DaveGuenther/Guenther-Chiptune/Guenther Chiptune Schematic.pdf

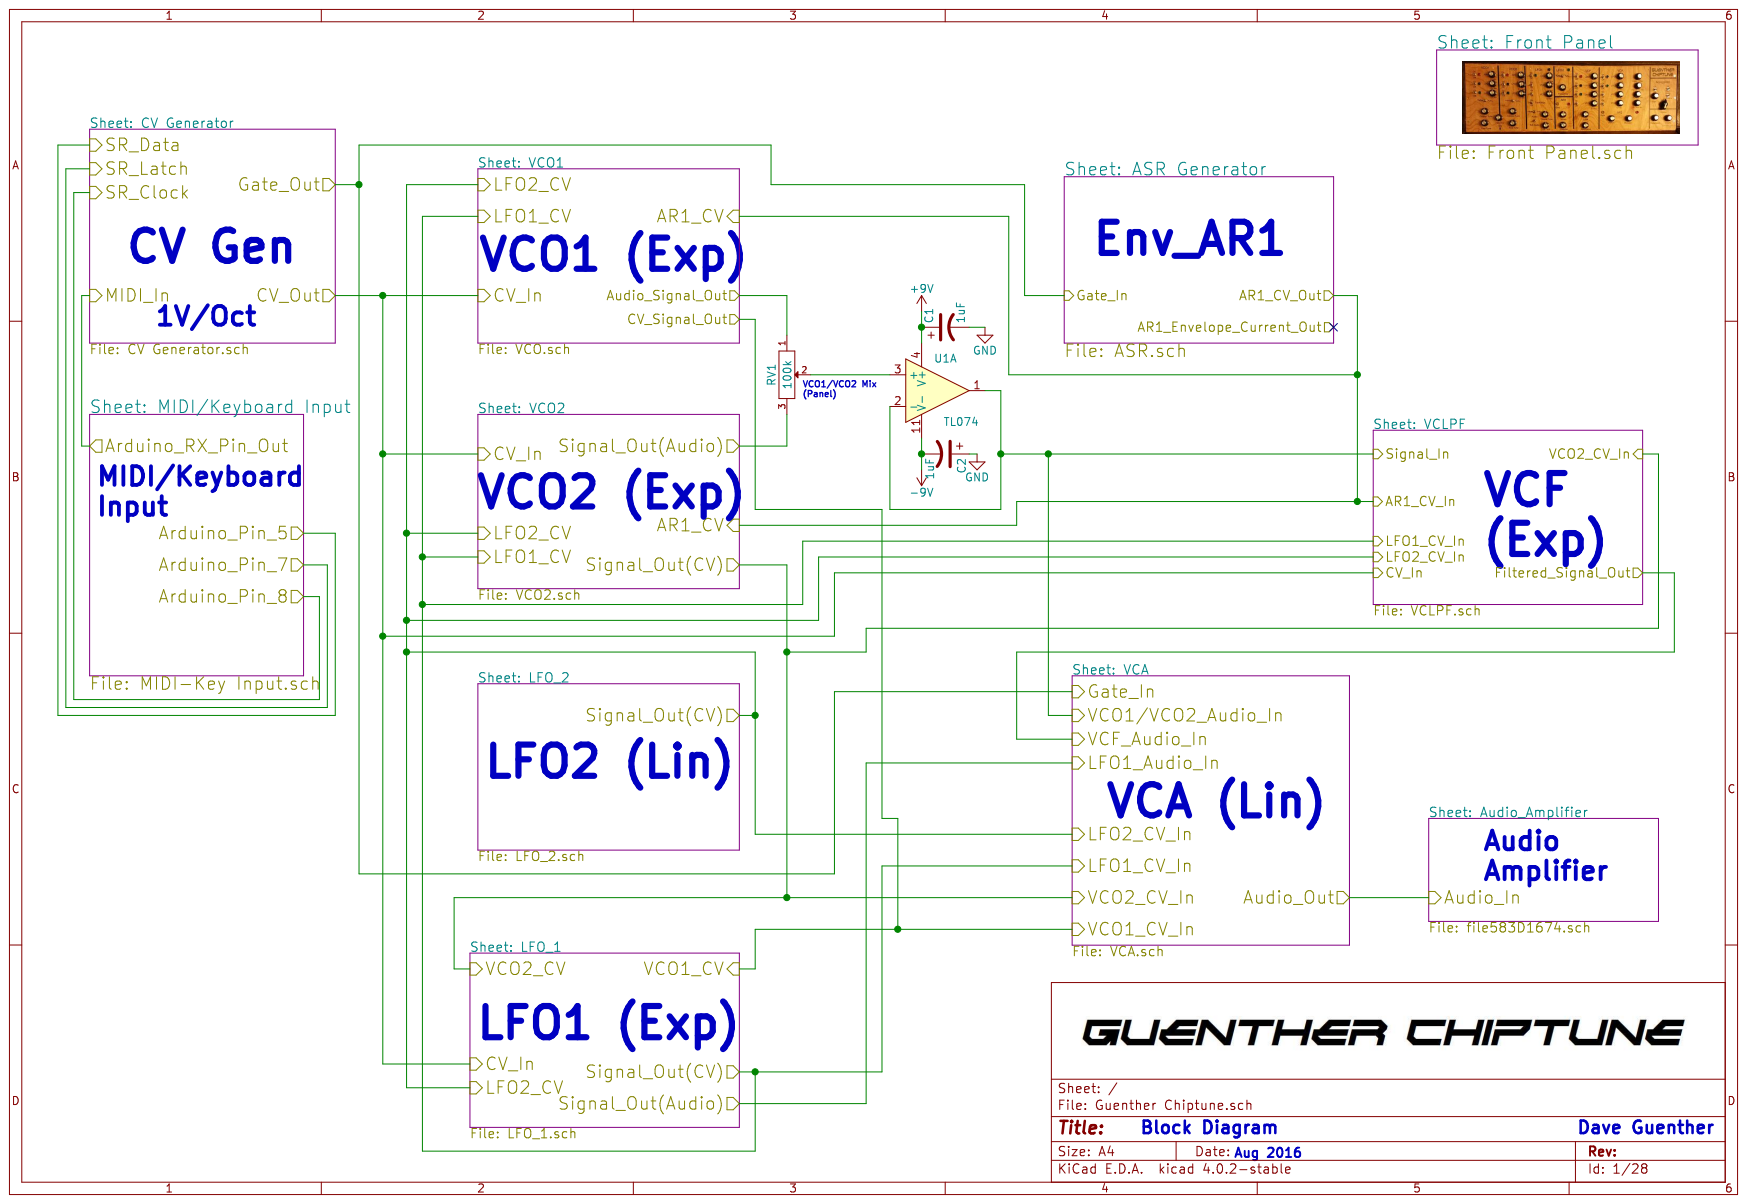
[picture p1: page 1]

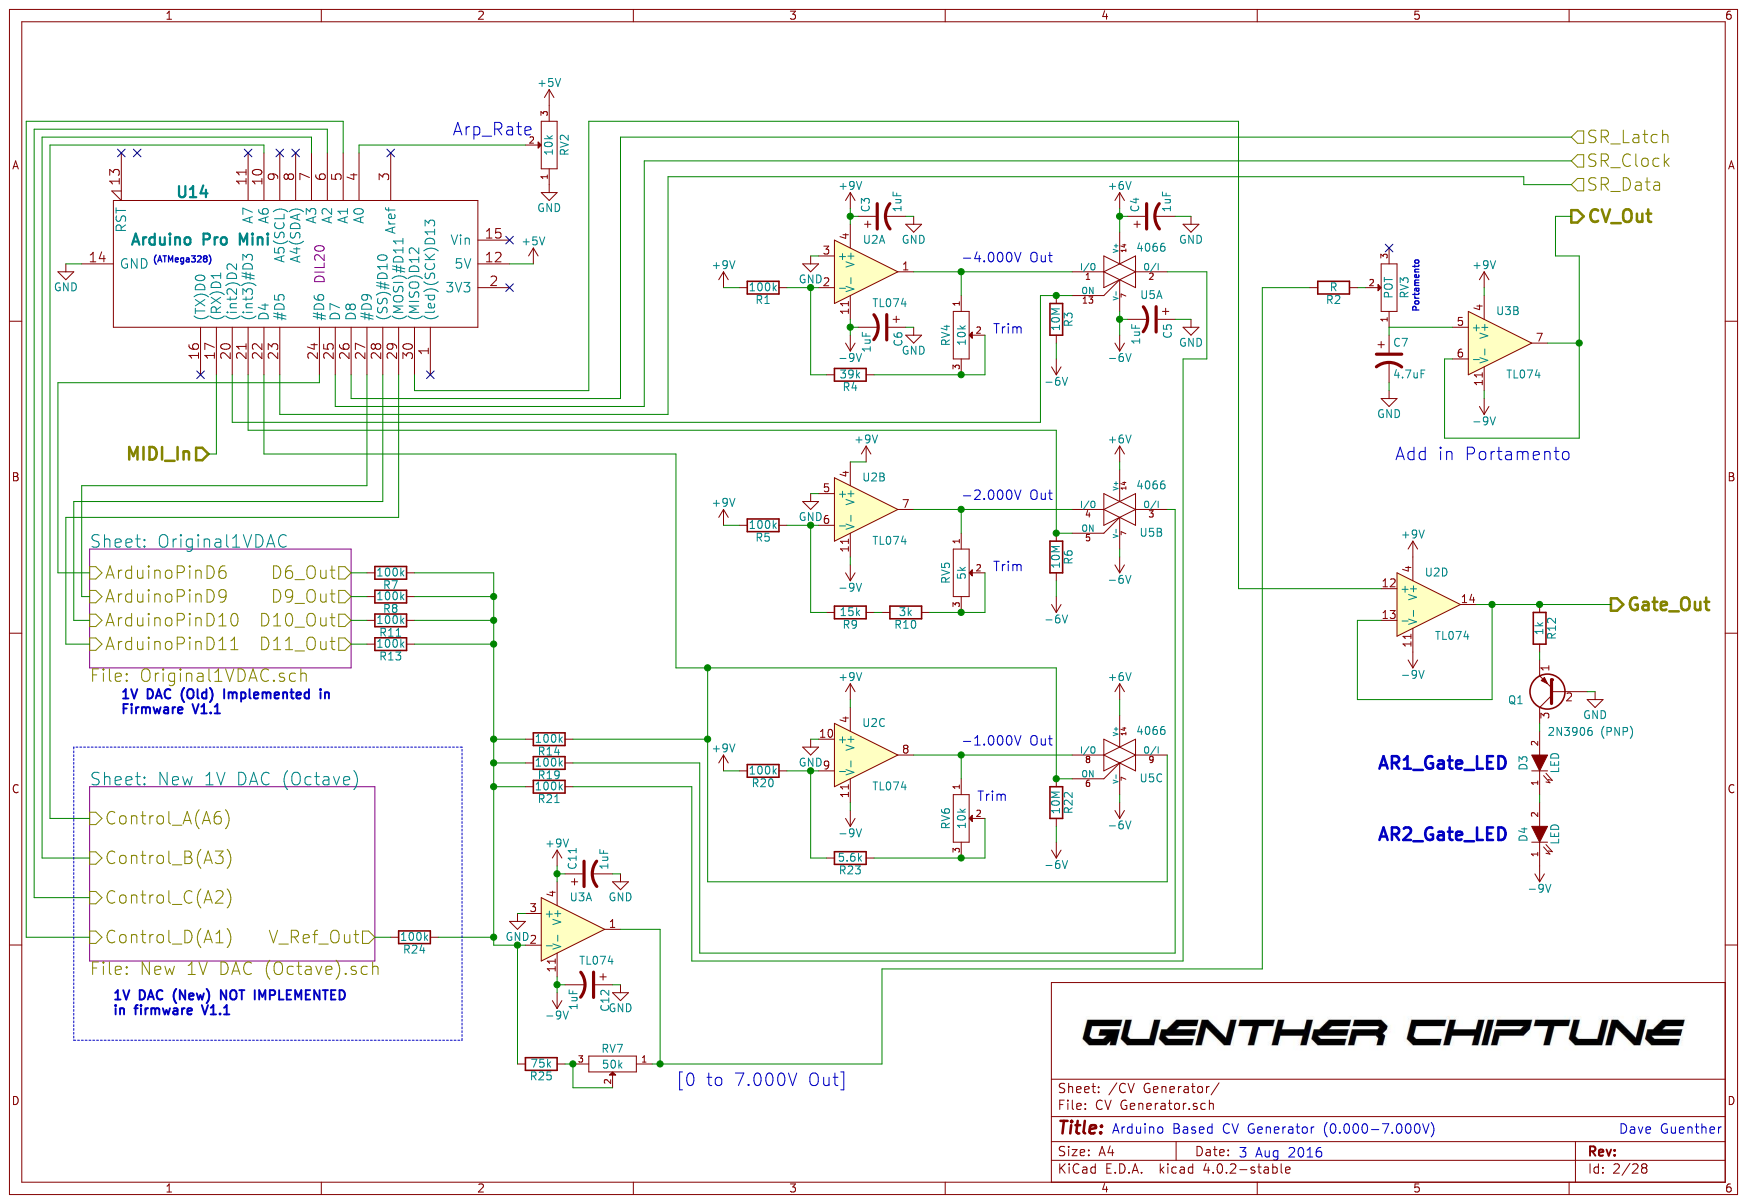
[picture p2: page 2]

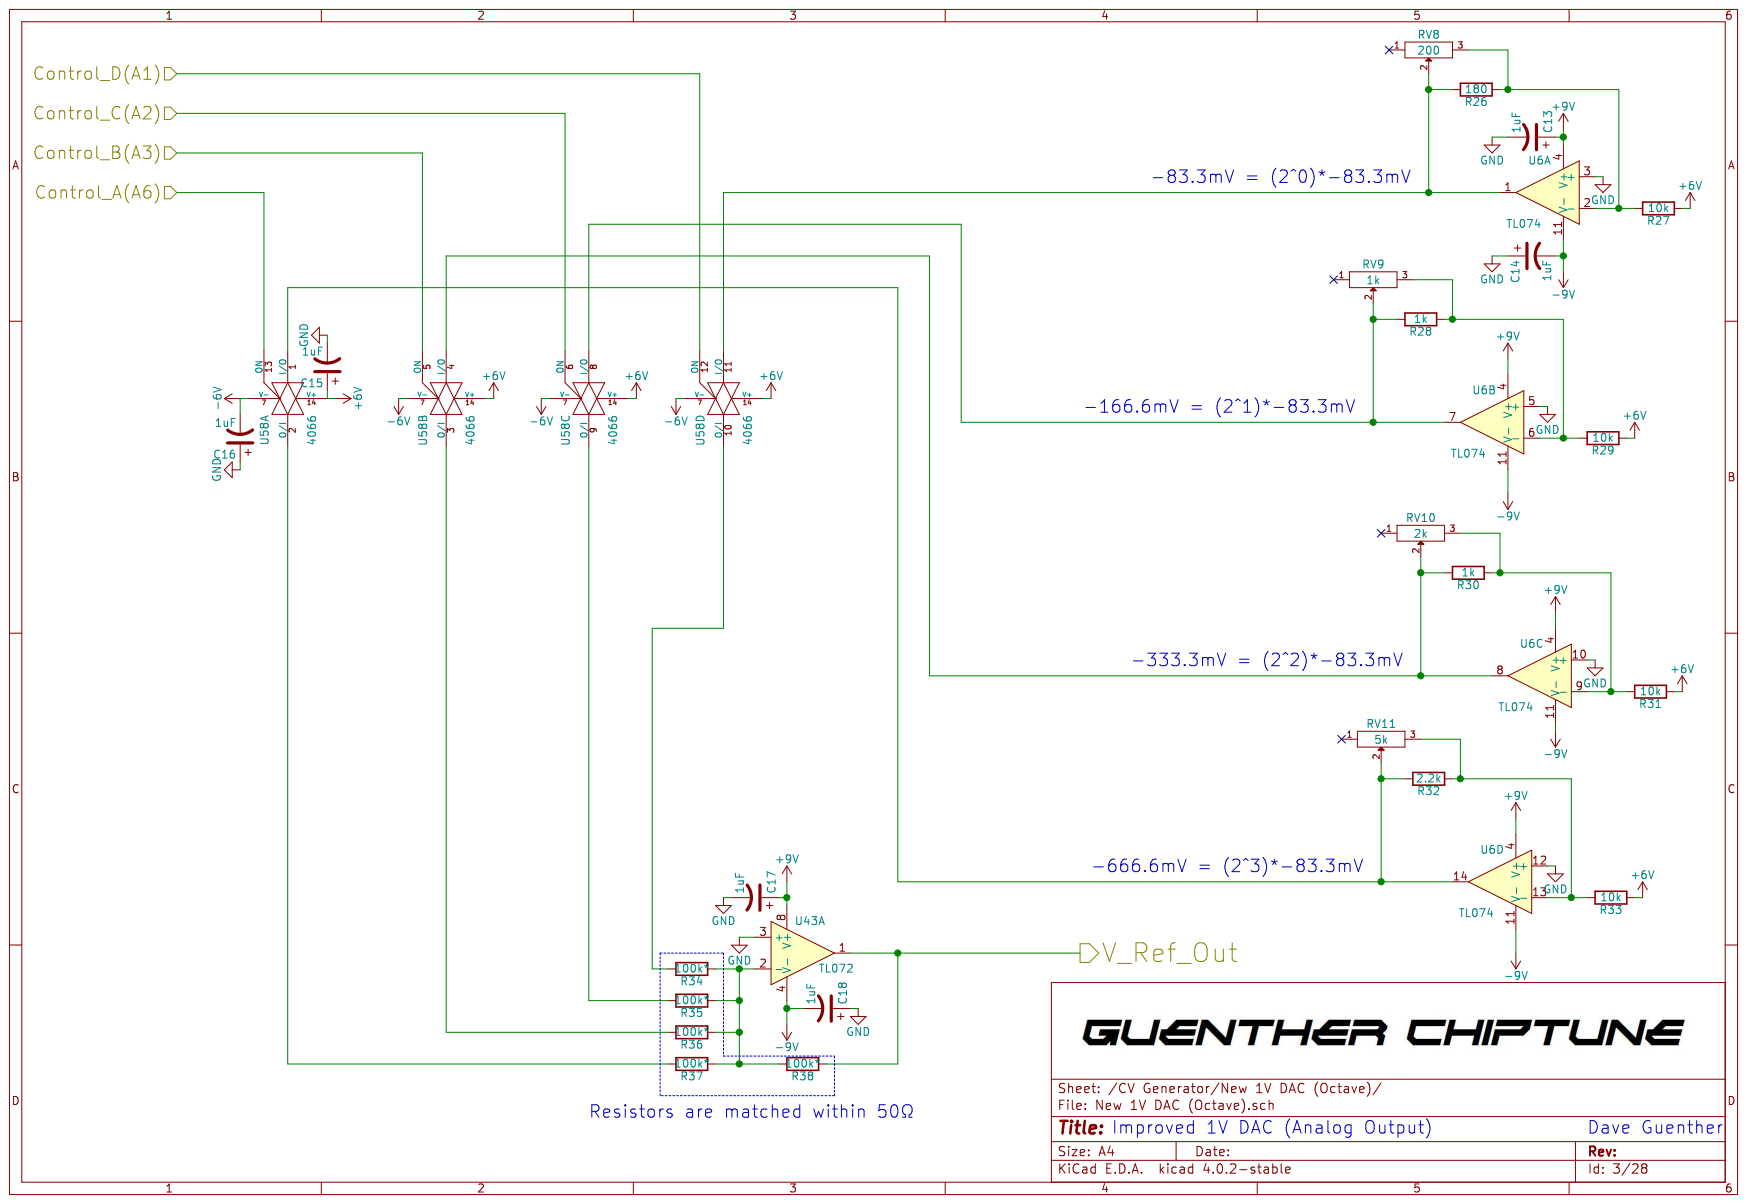
[picture p3: page 3]

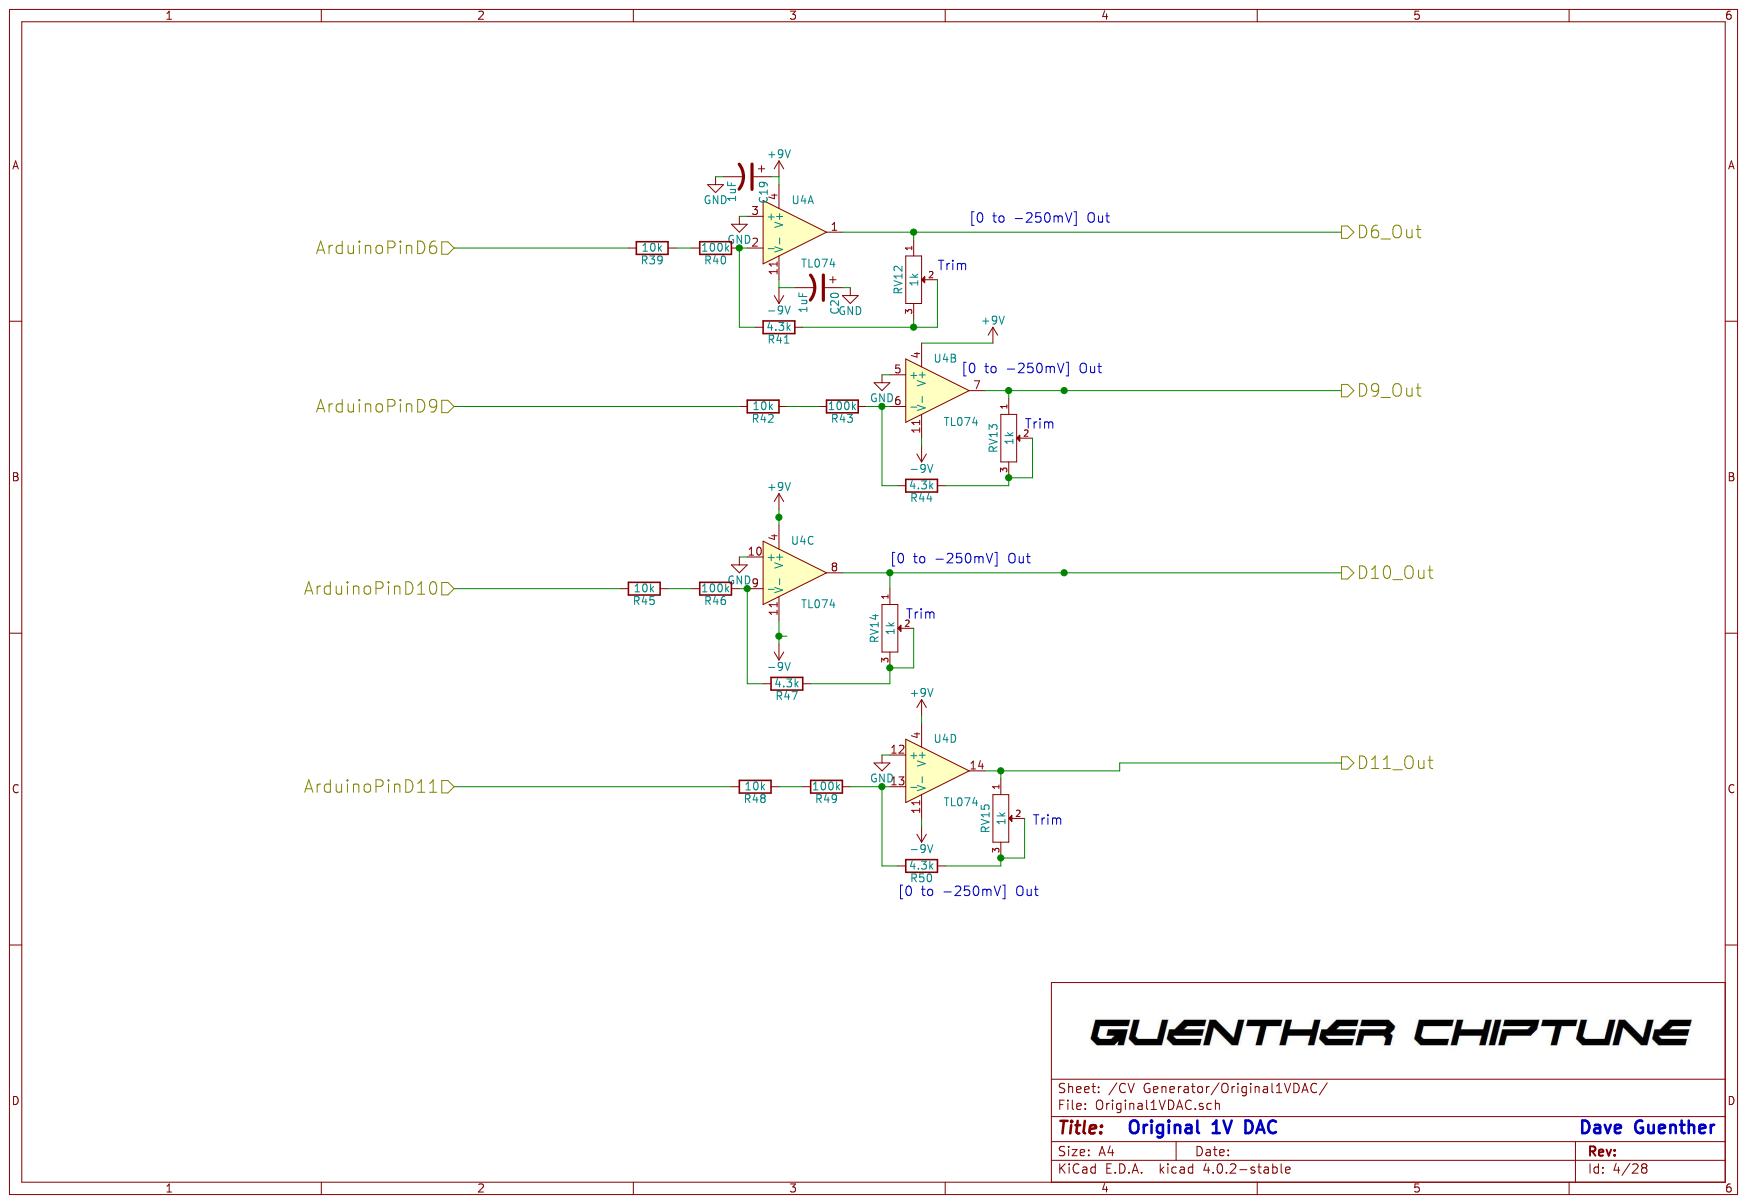
[picture p4: page 4]

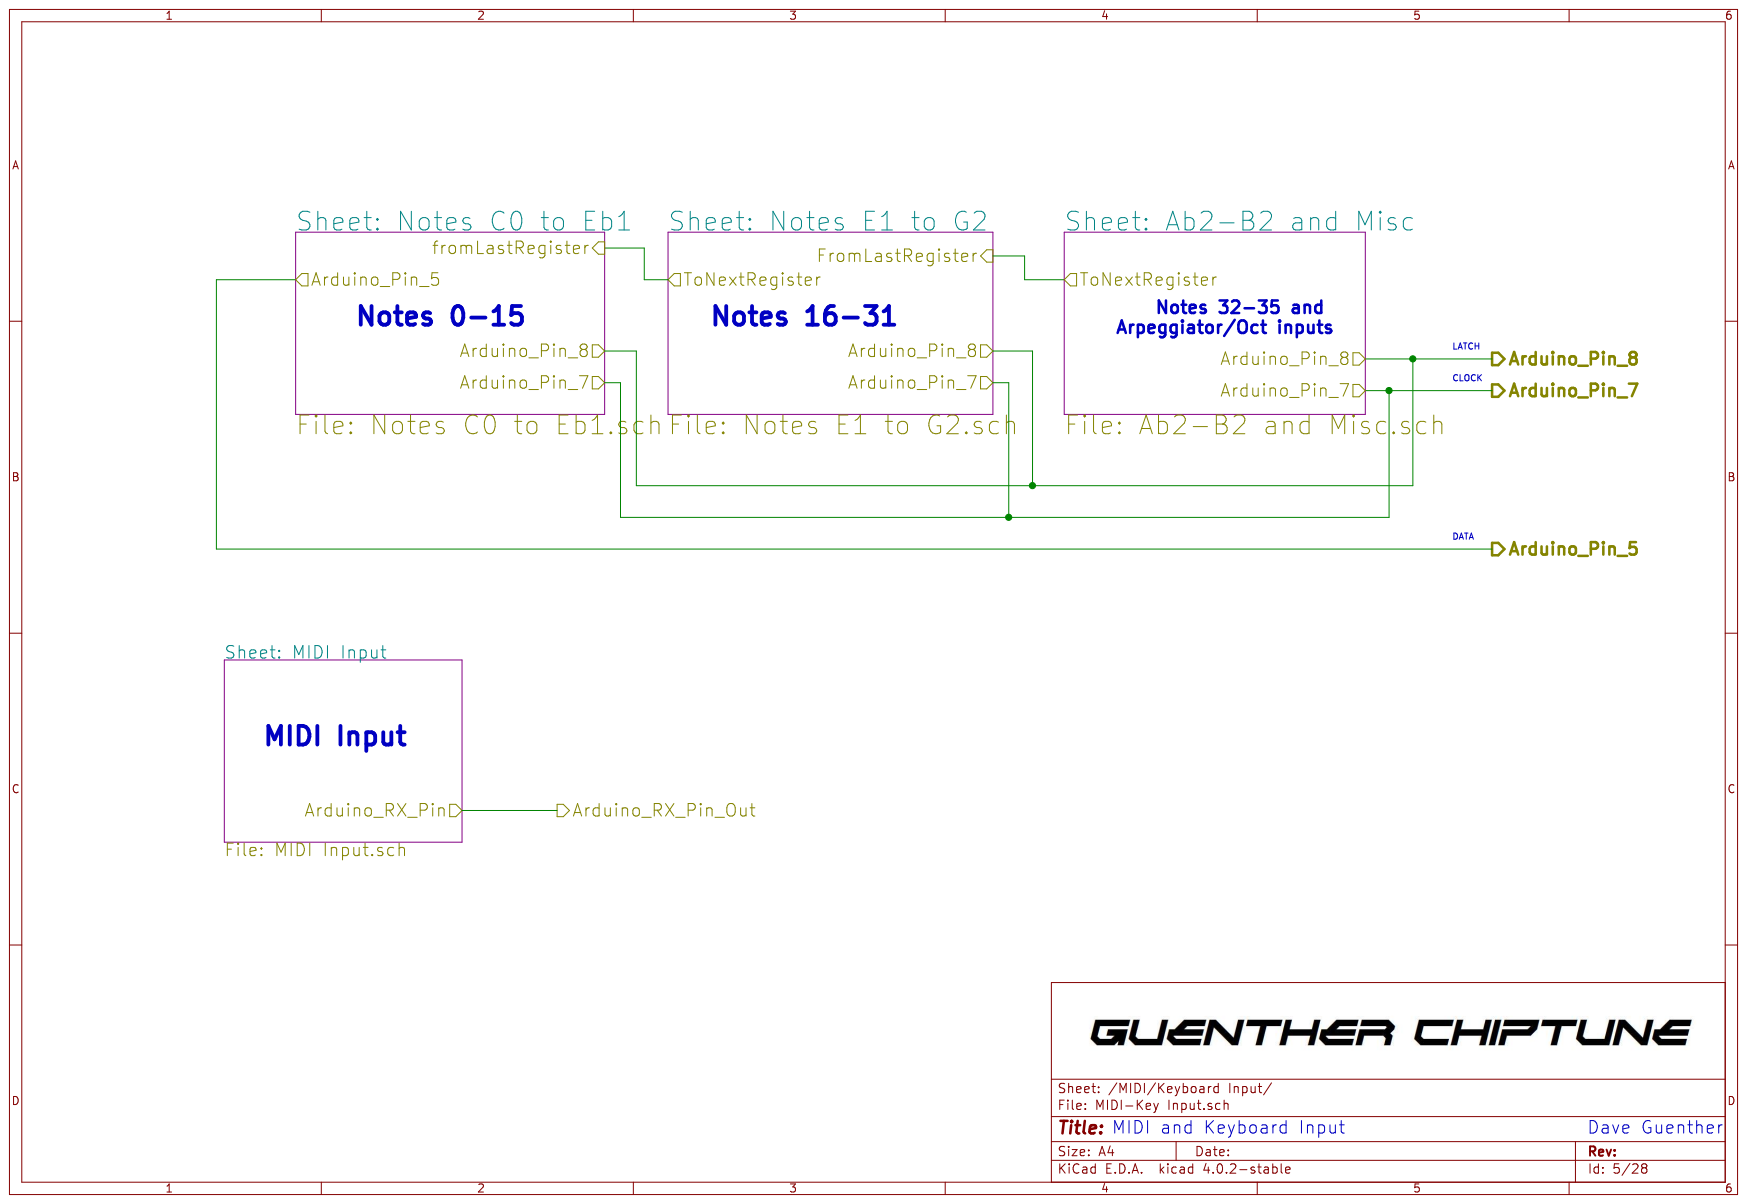
[picture p5: page 5]

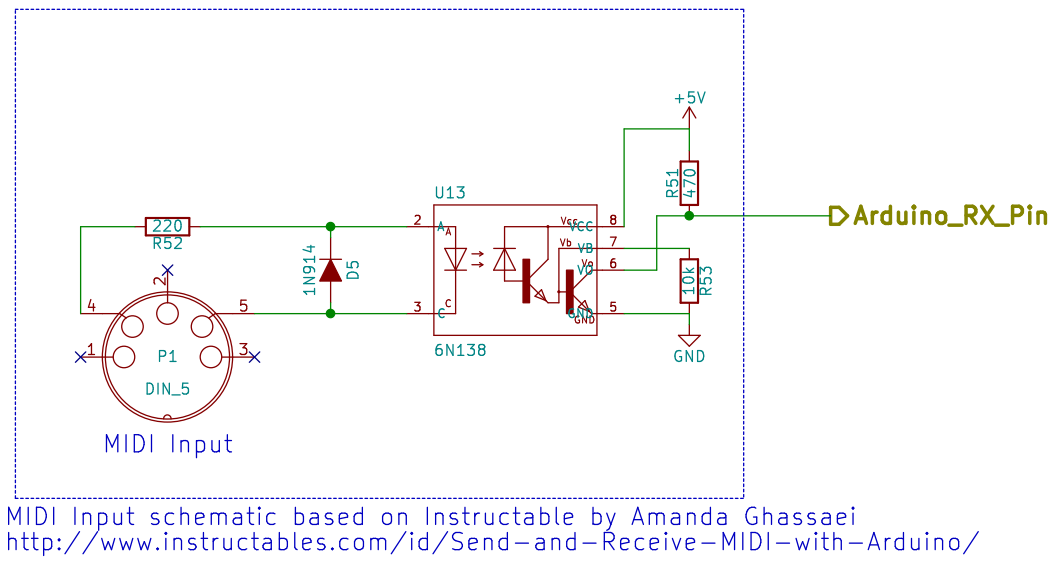
[picture p6: page 6]

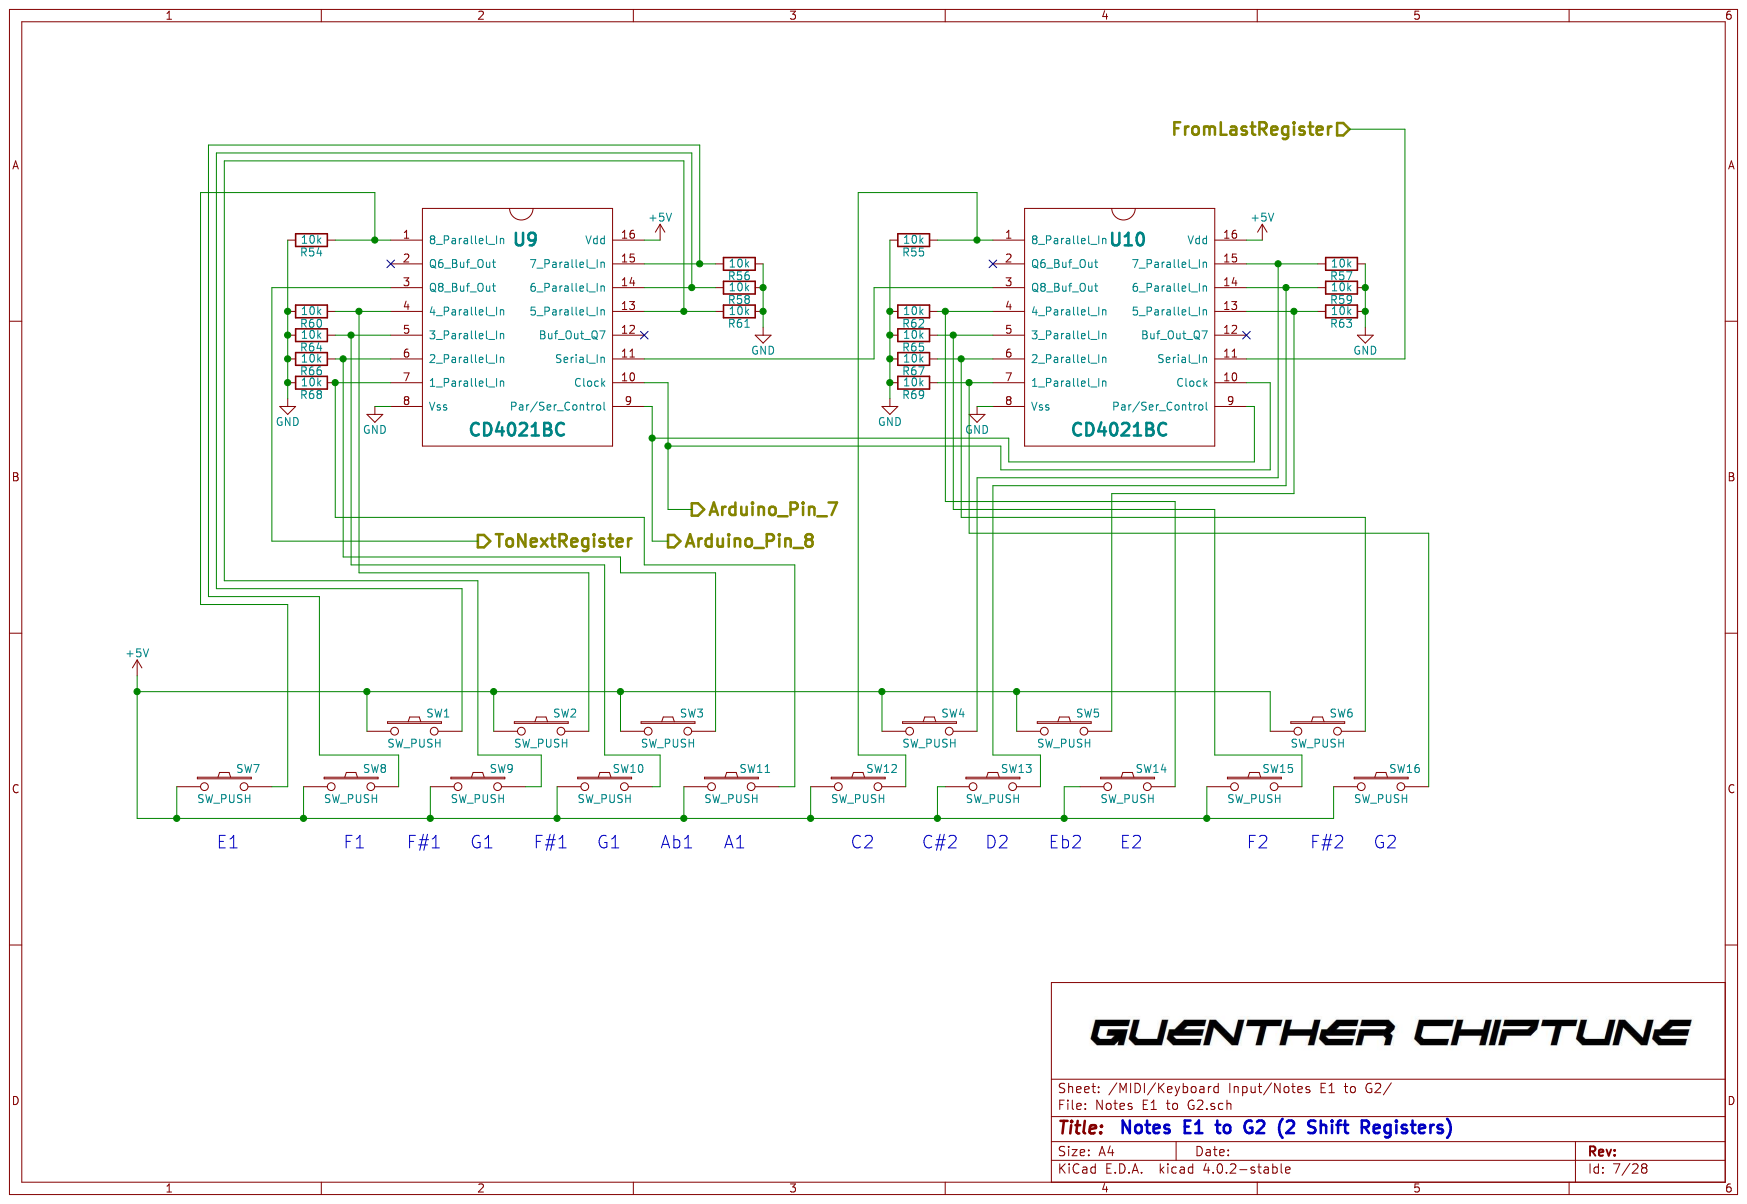
[picture p7: page 7]

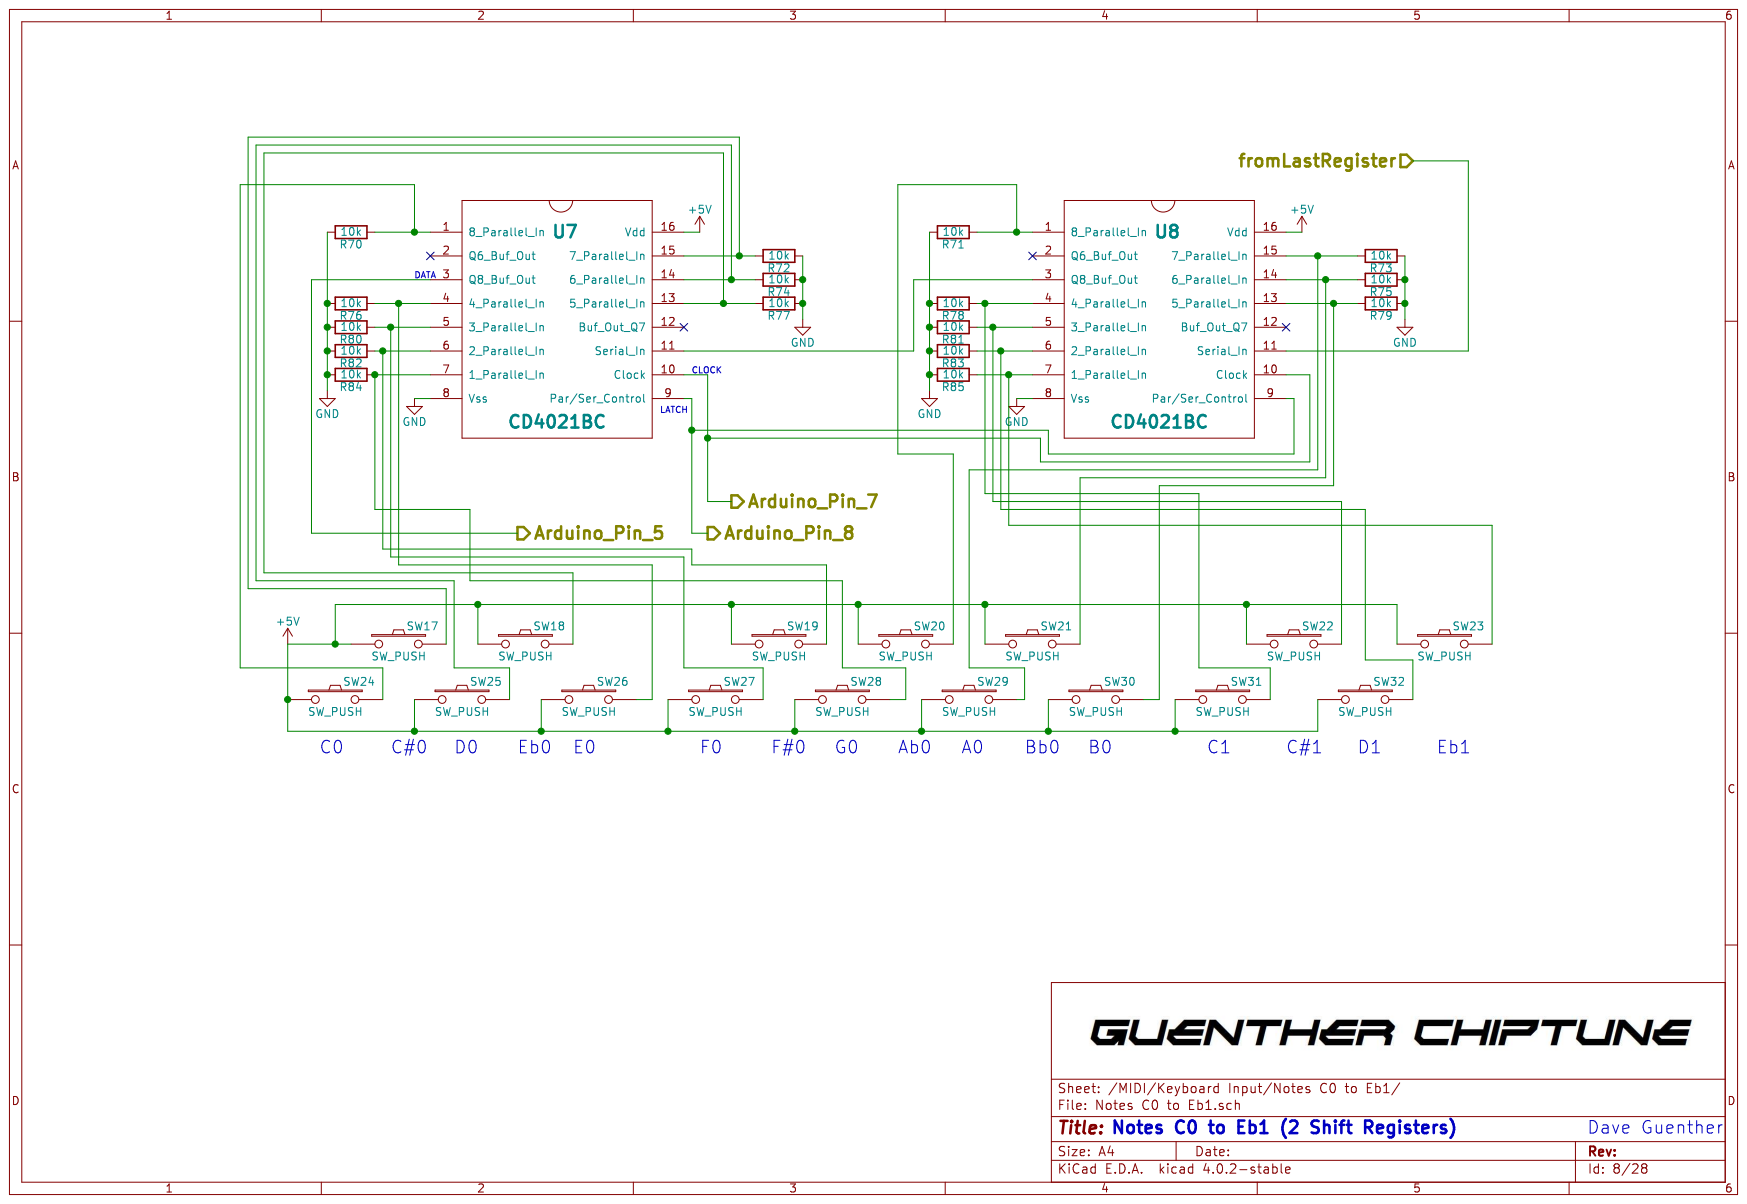
[picture p8: page 8]

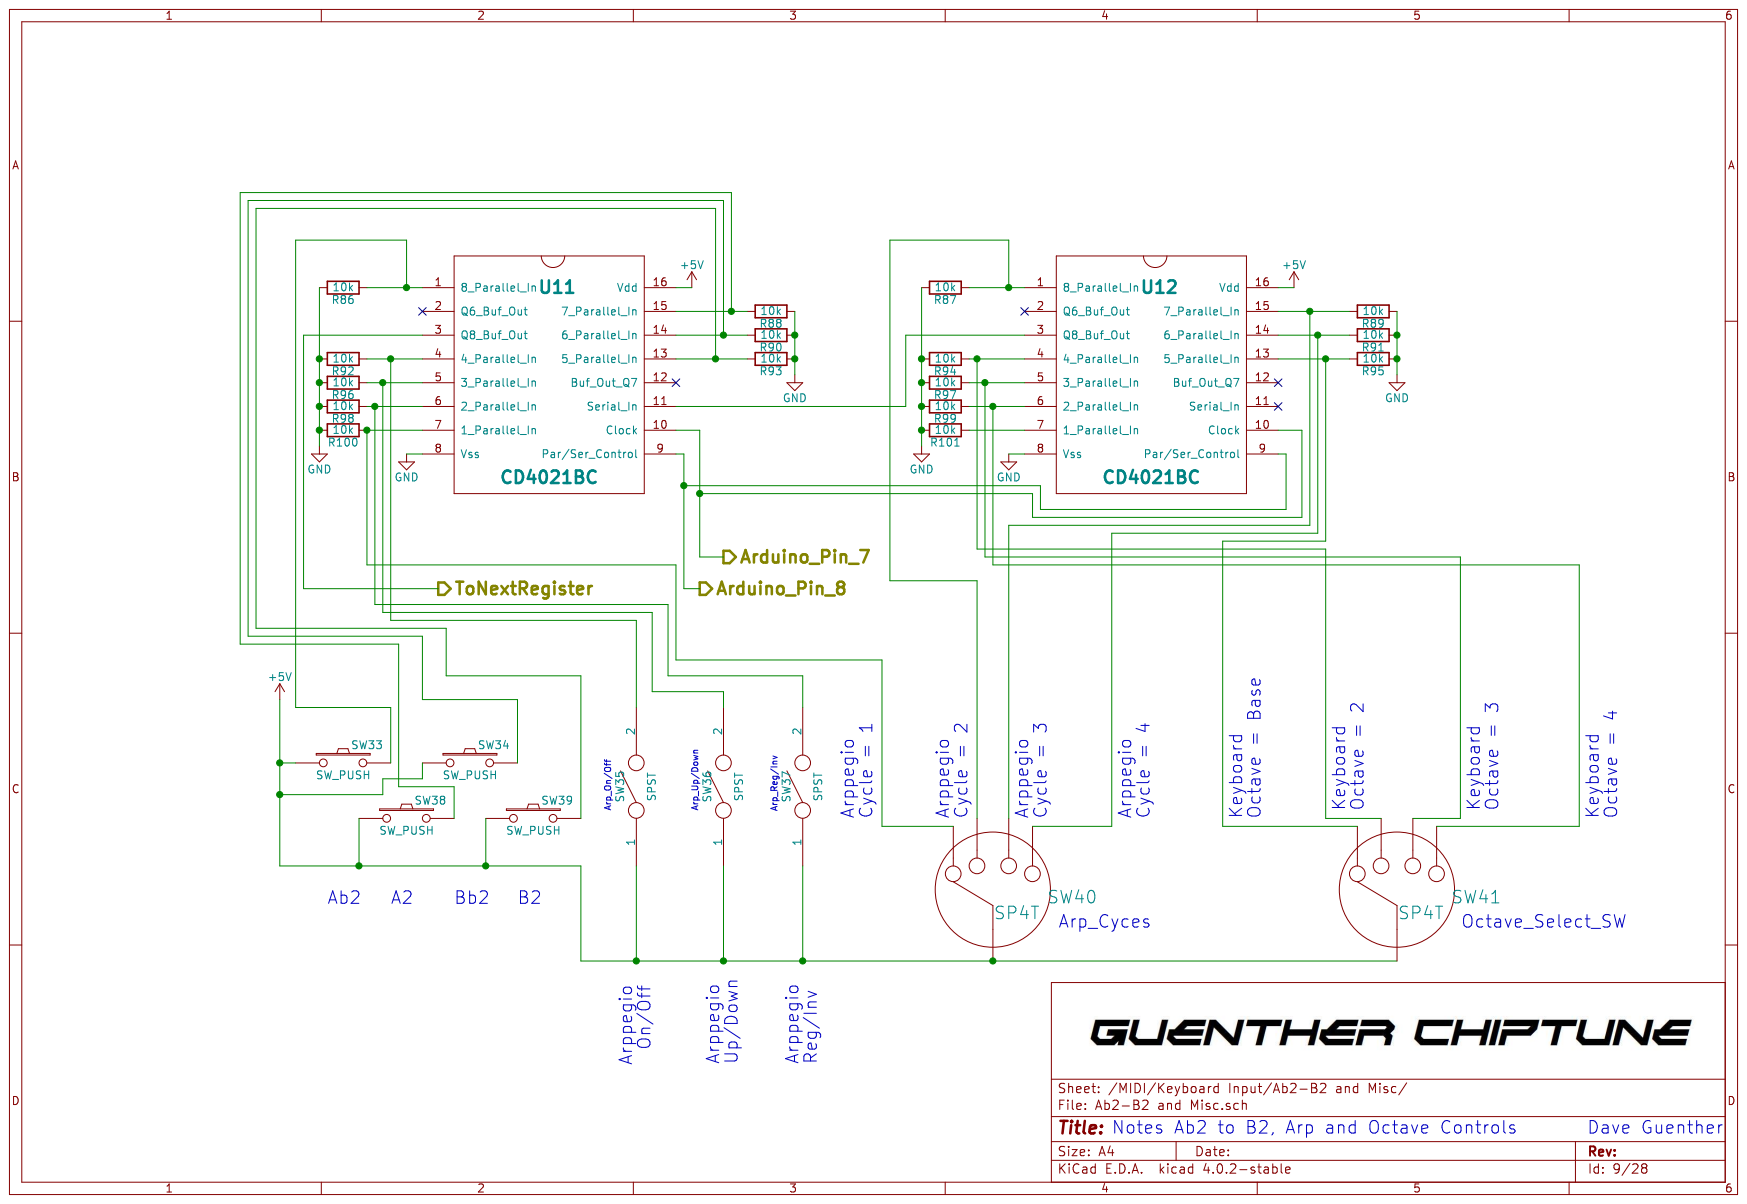
[picture p9: page 9]

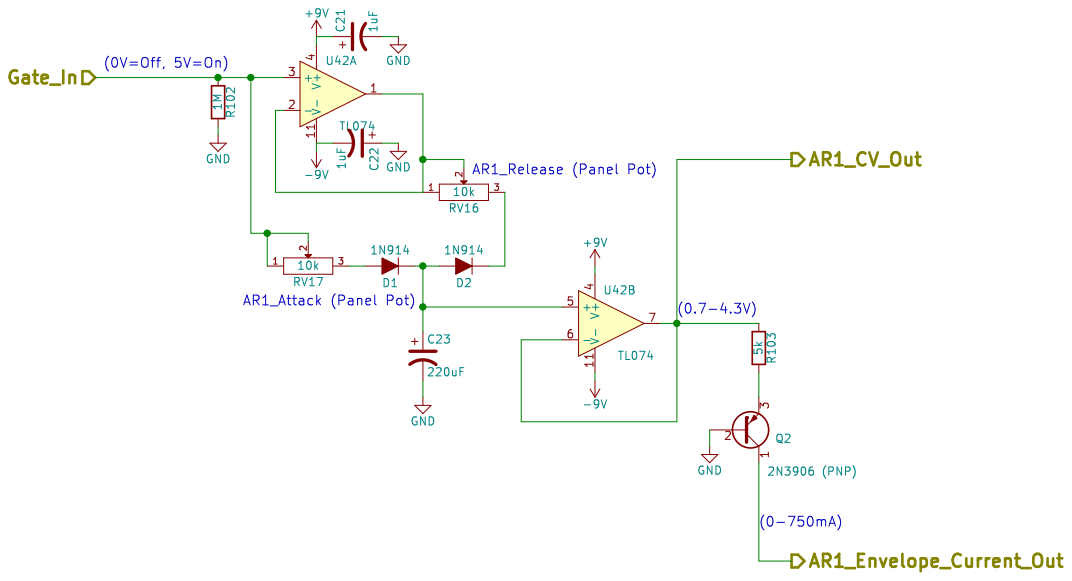
[picture p10: page 10]

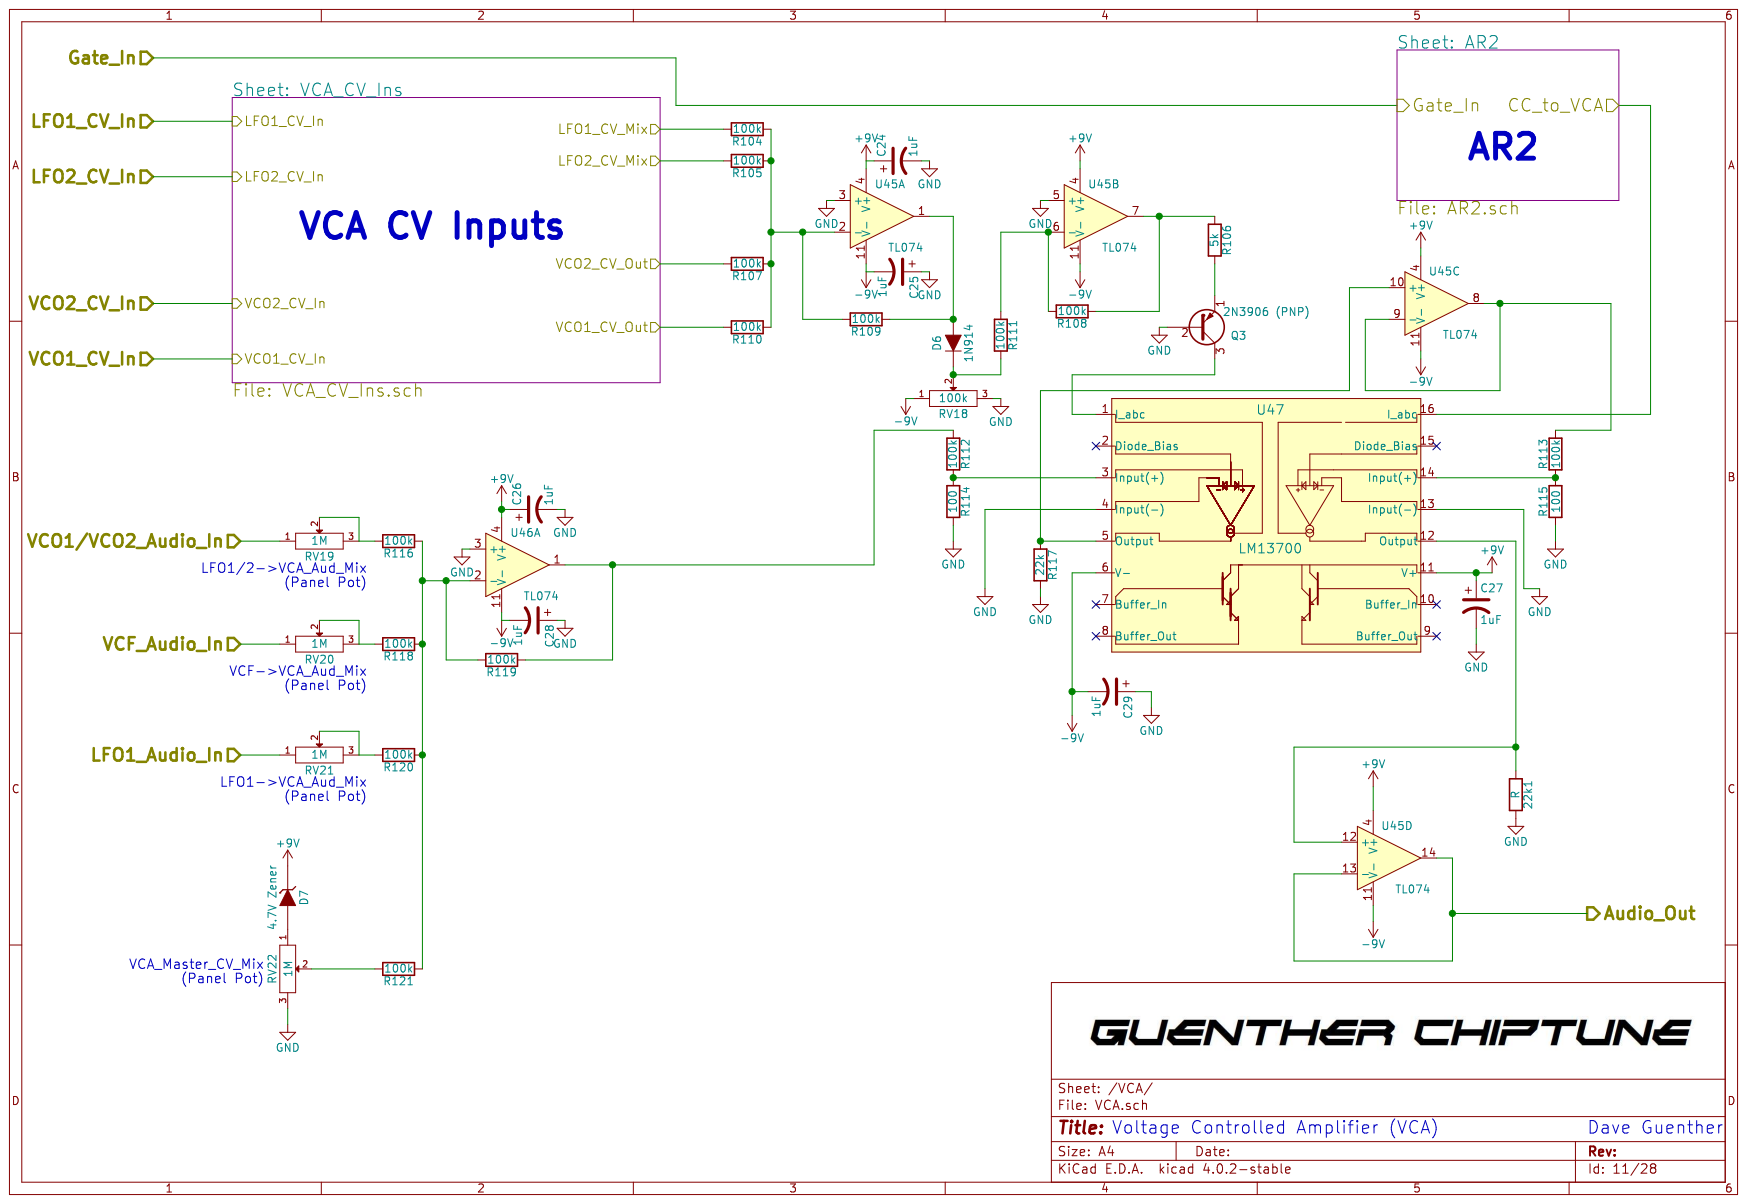
[picture p11: page 11]

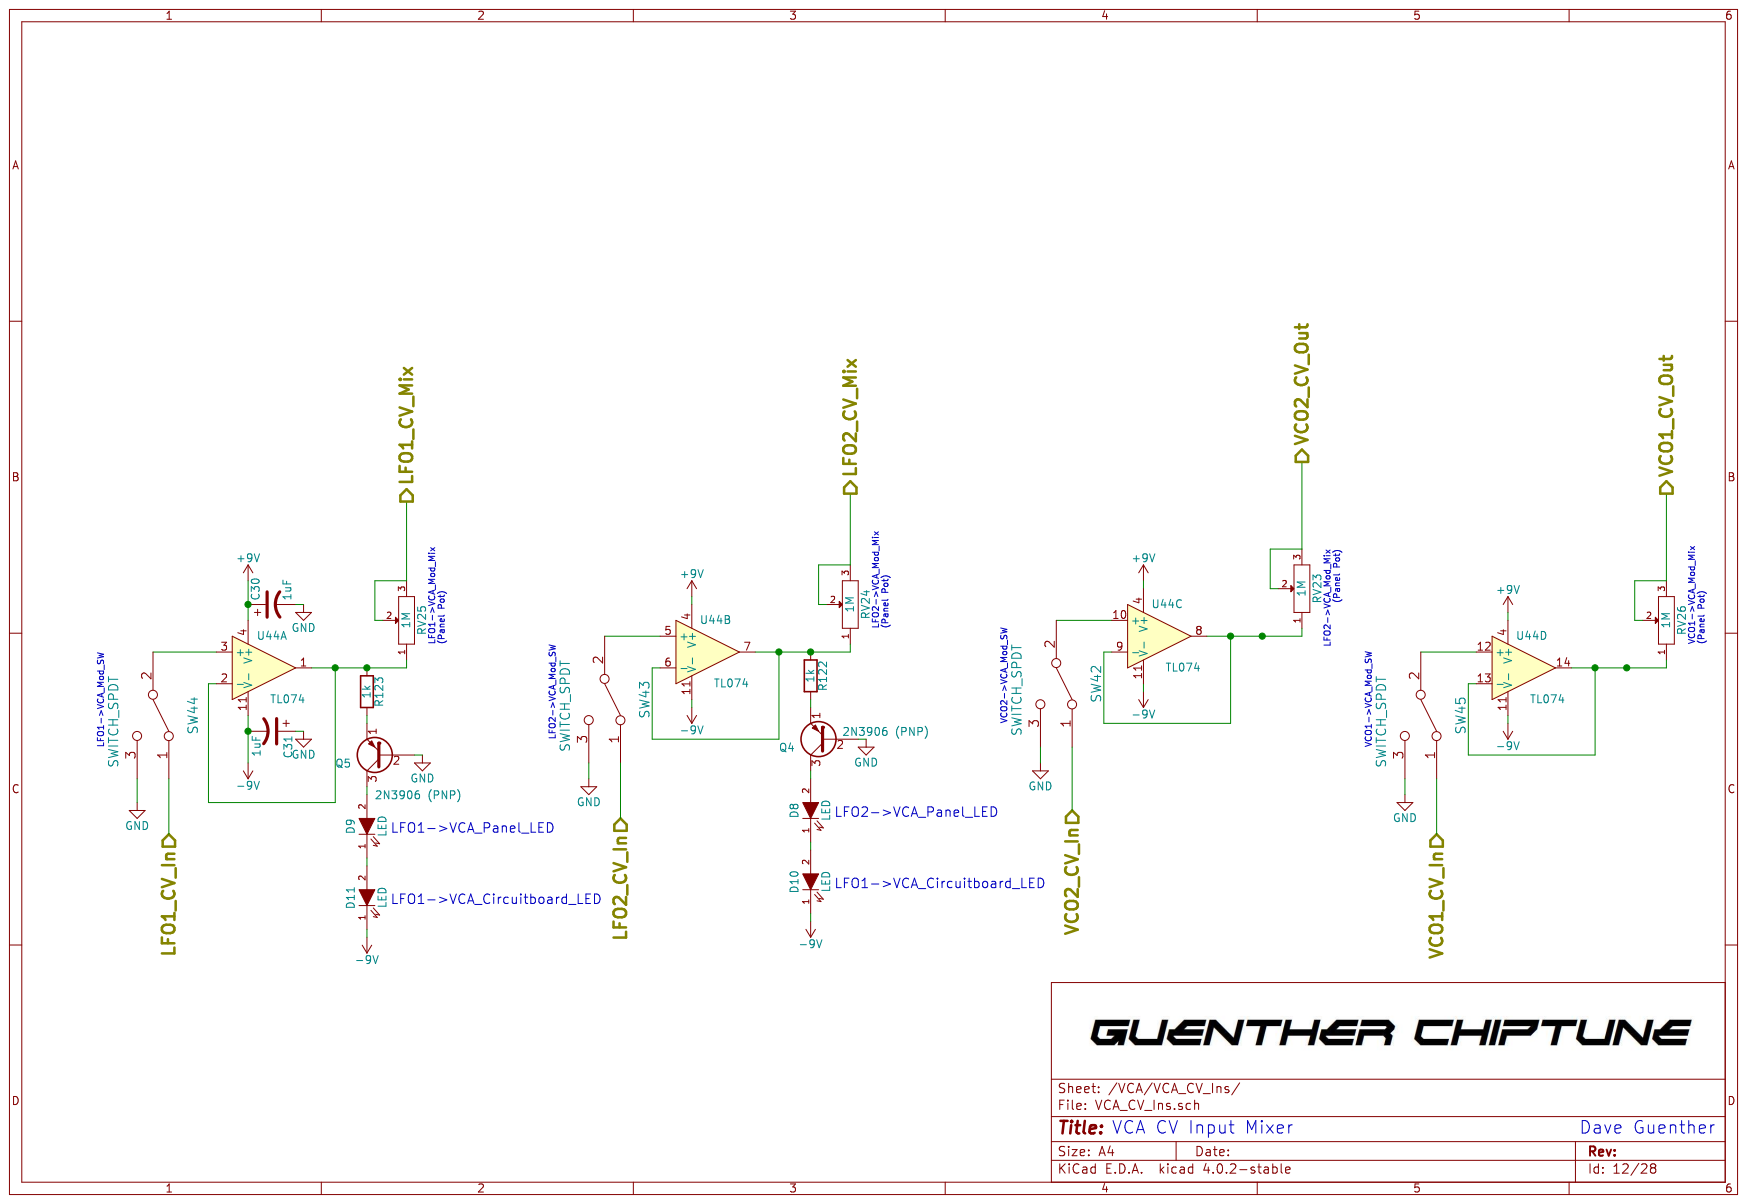
[picture p12: page 12]

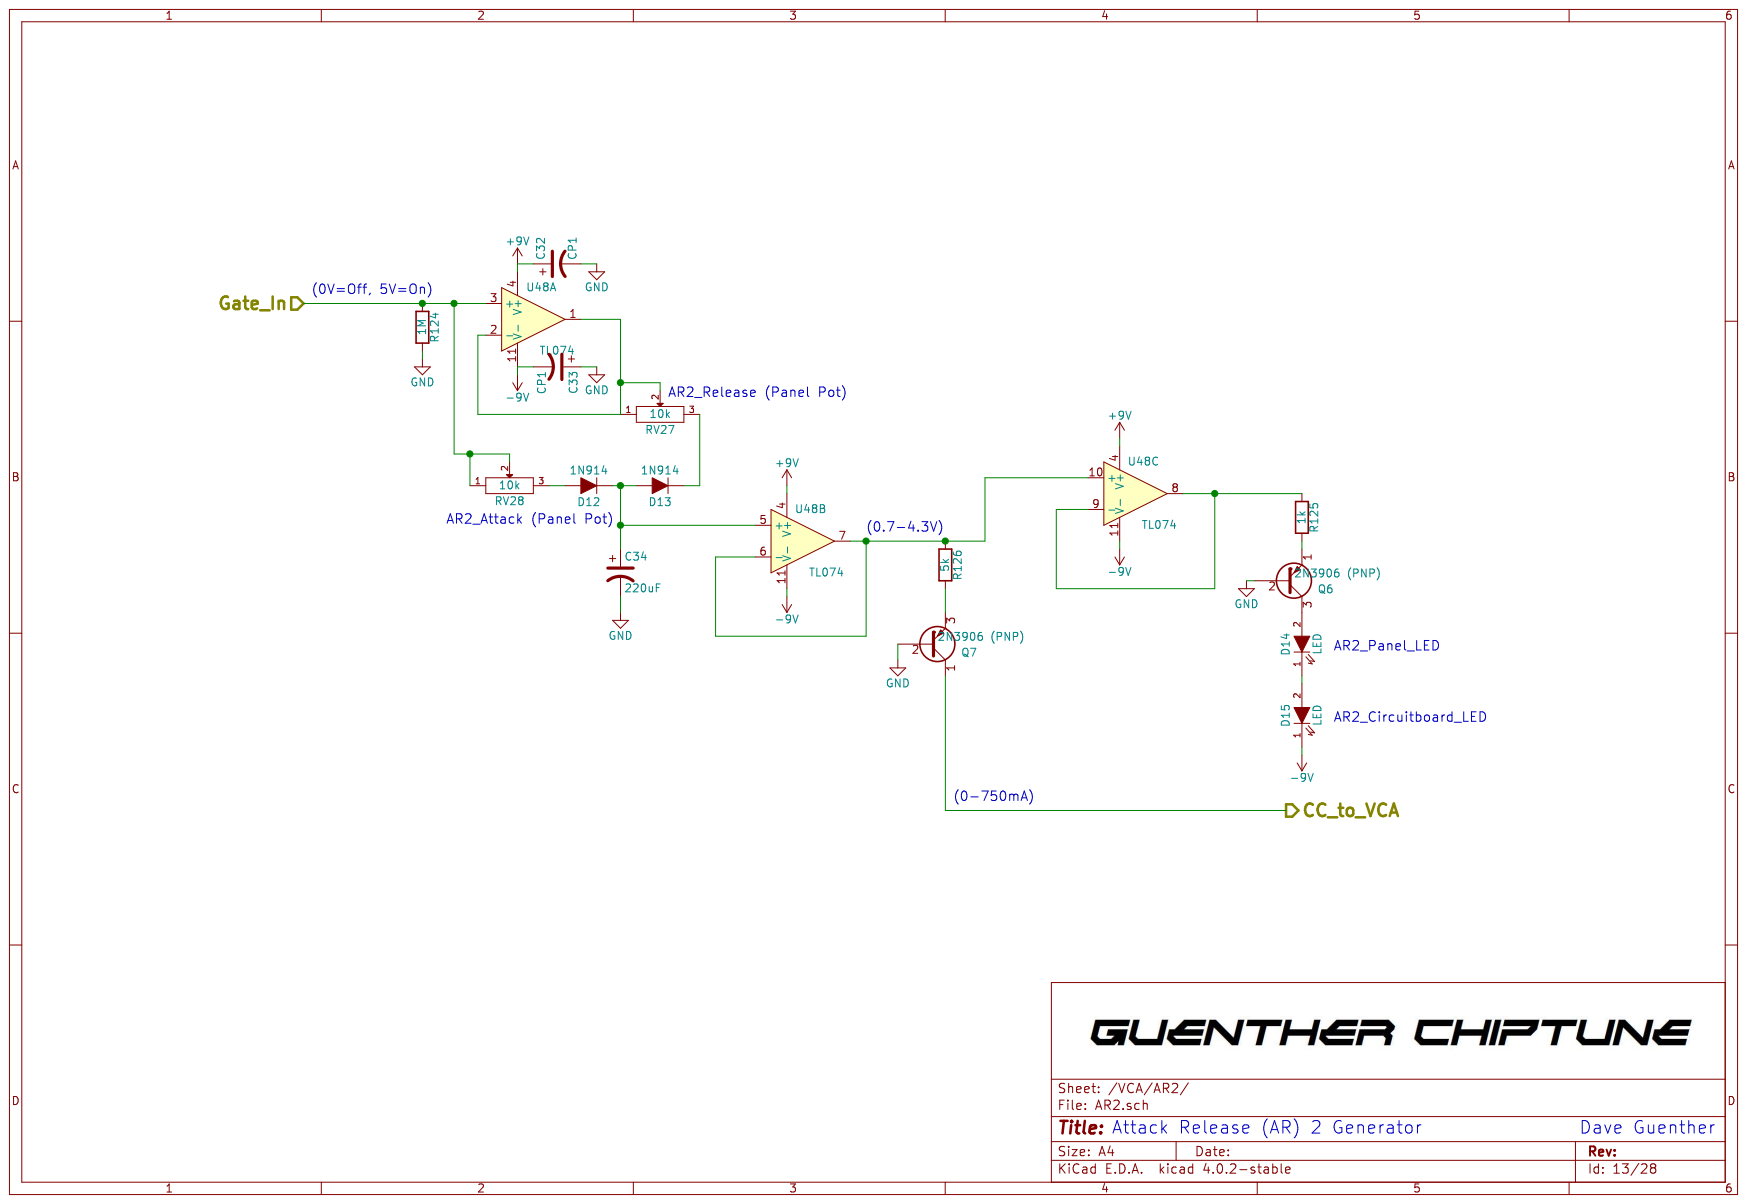
[picture p13: page 13]

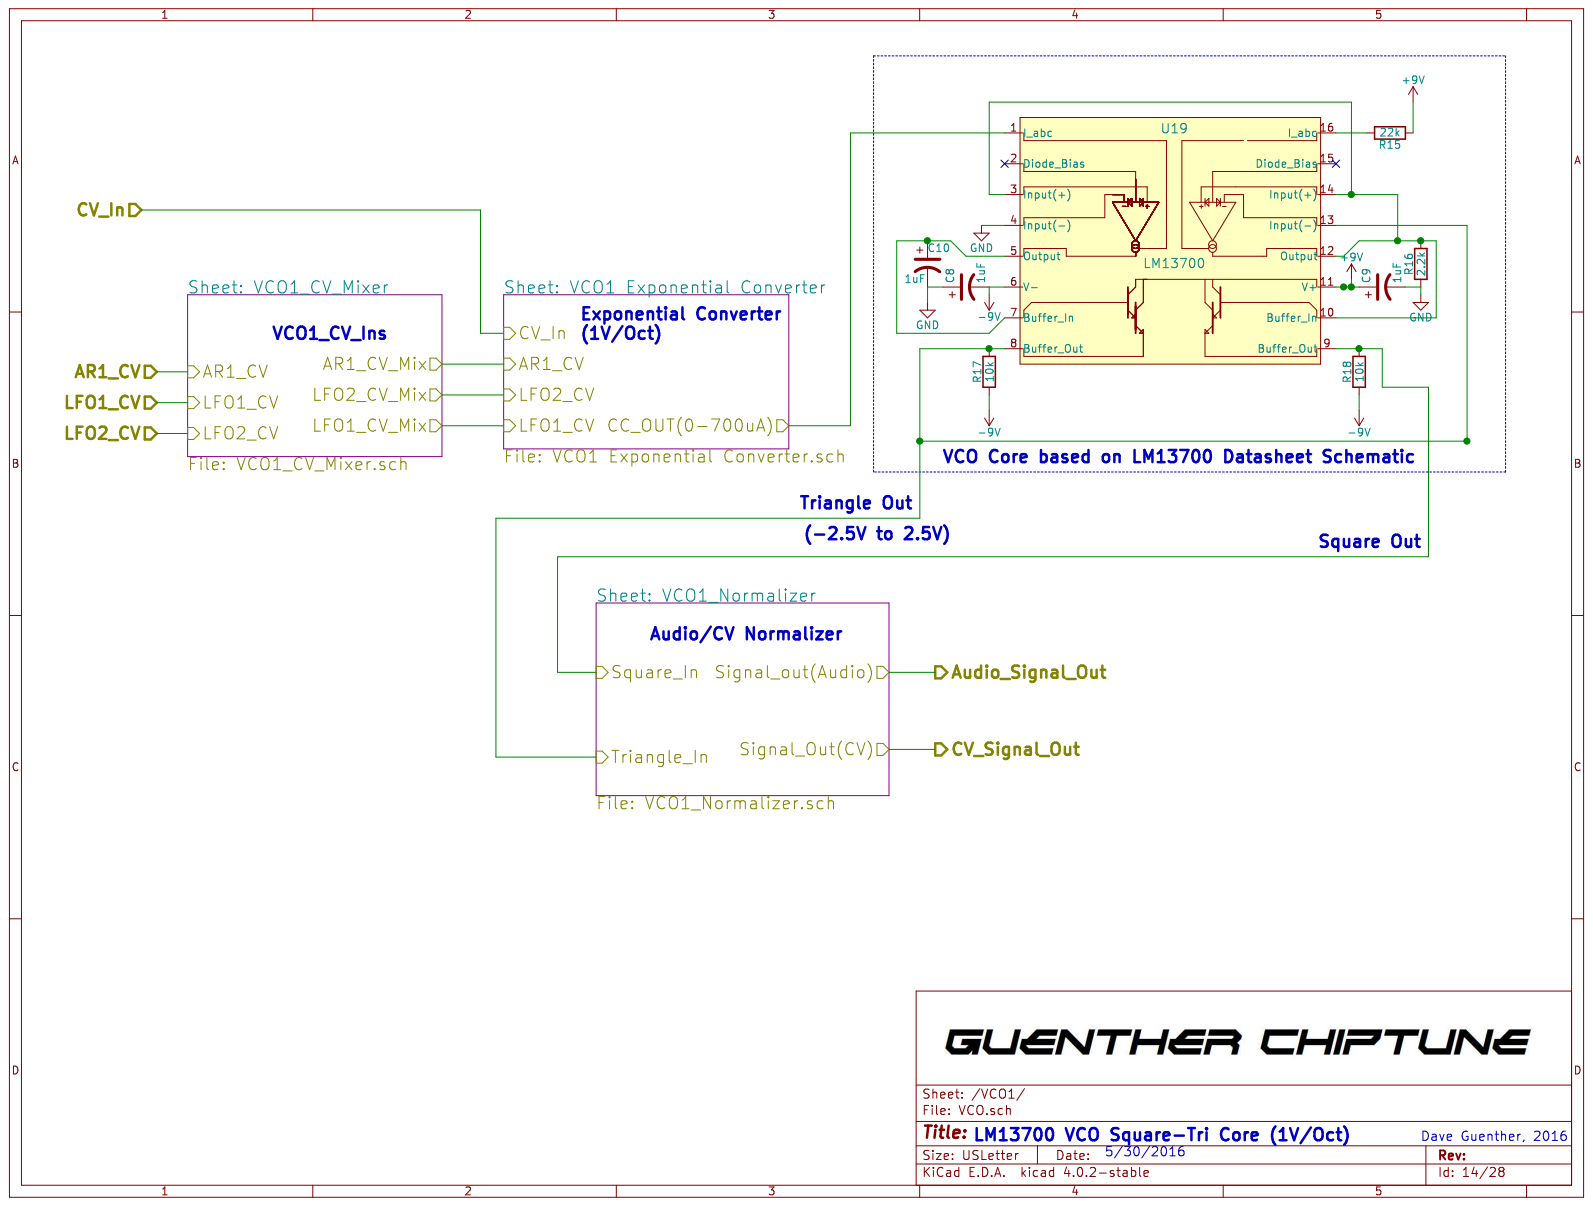
[picture p14: page 14]

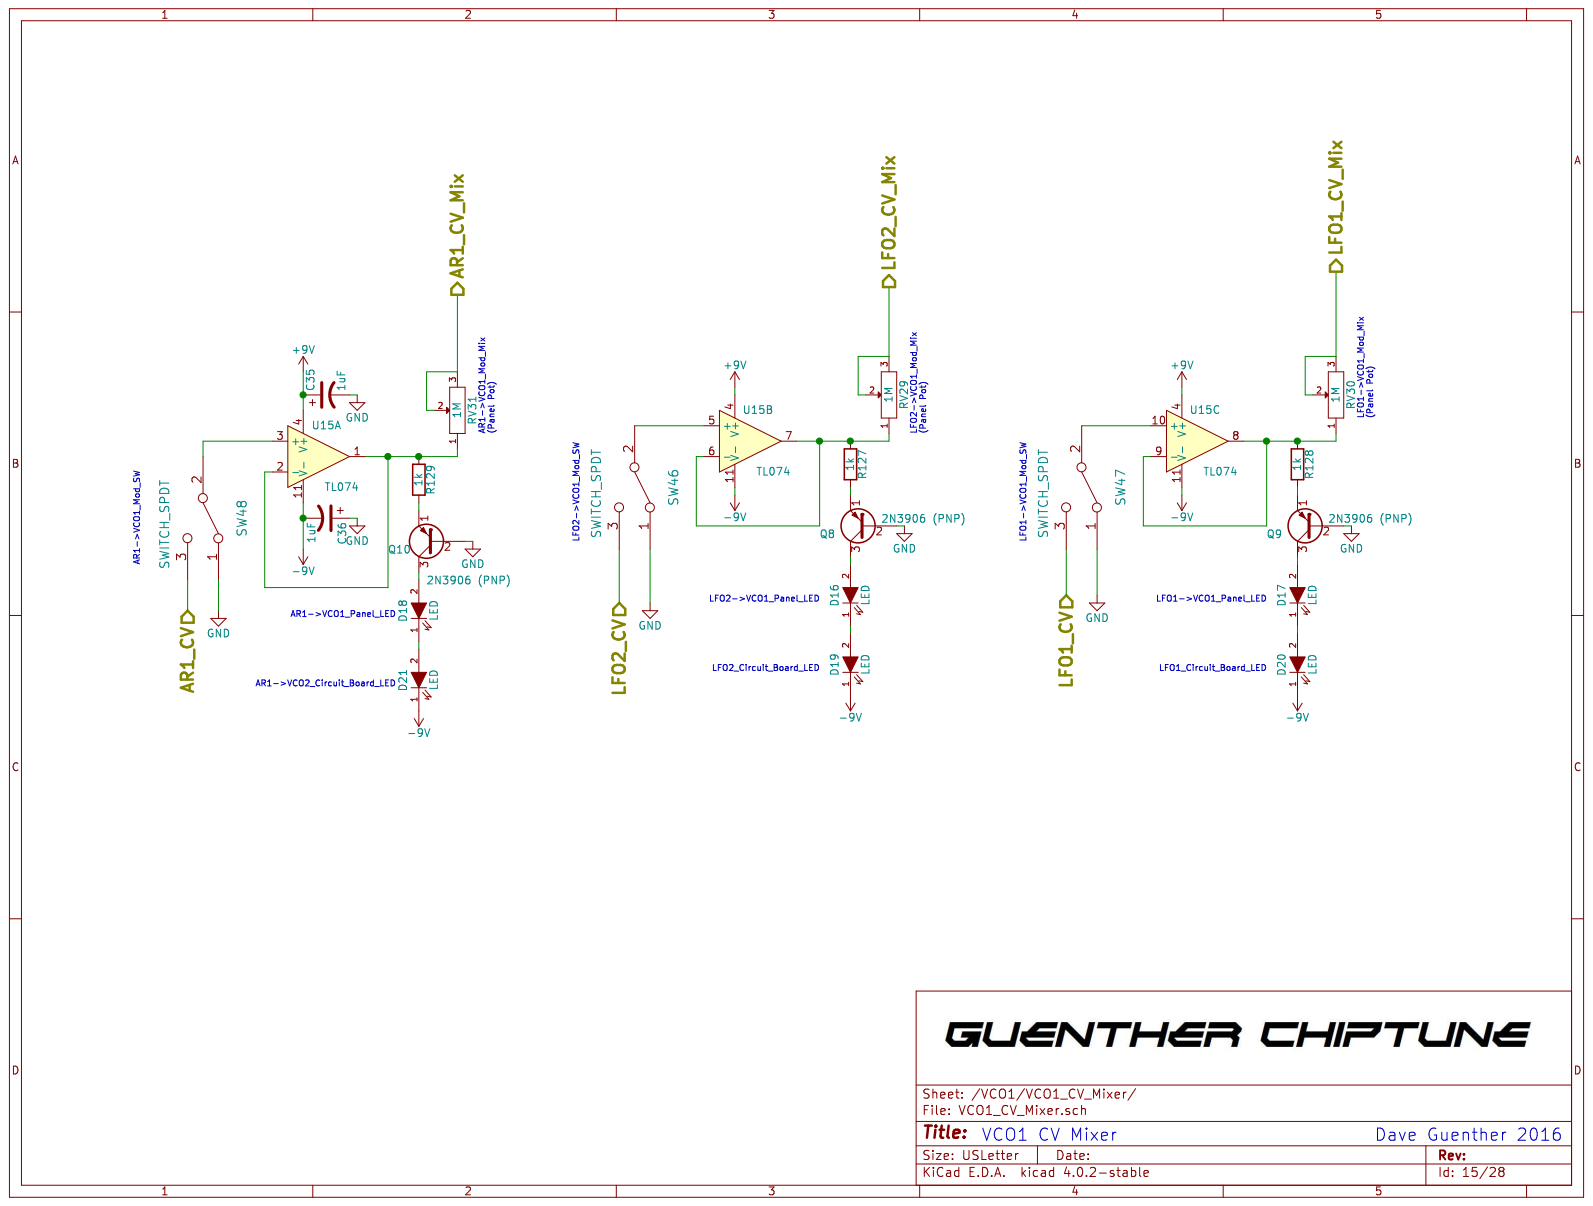
[picture p15: page 15]

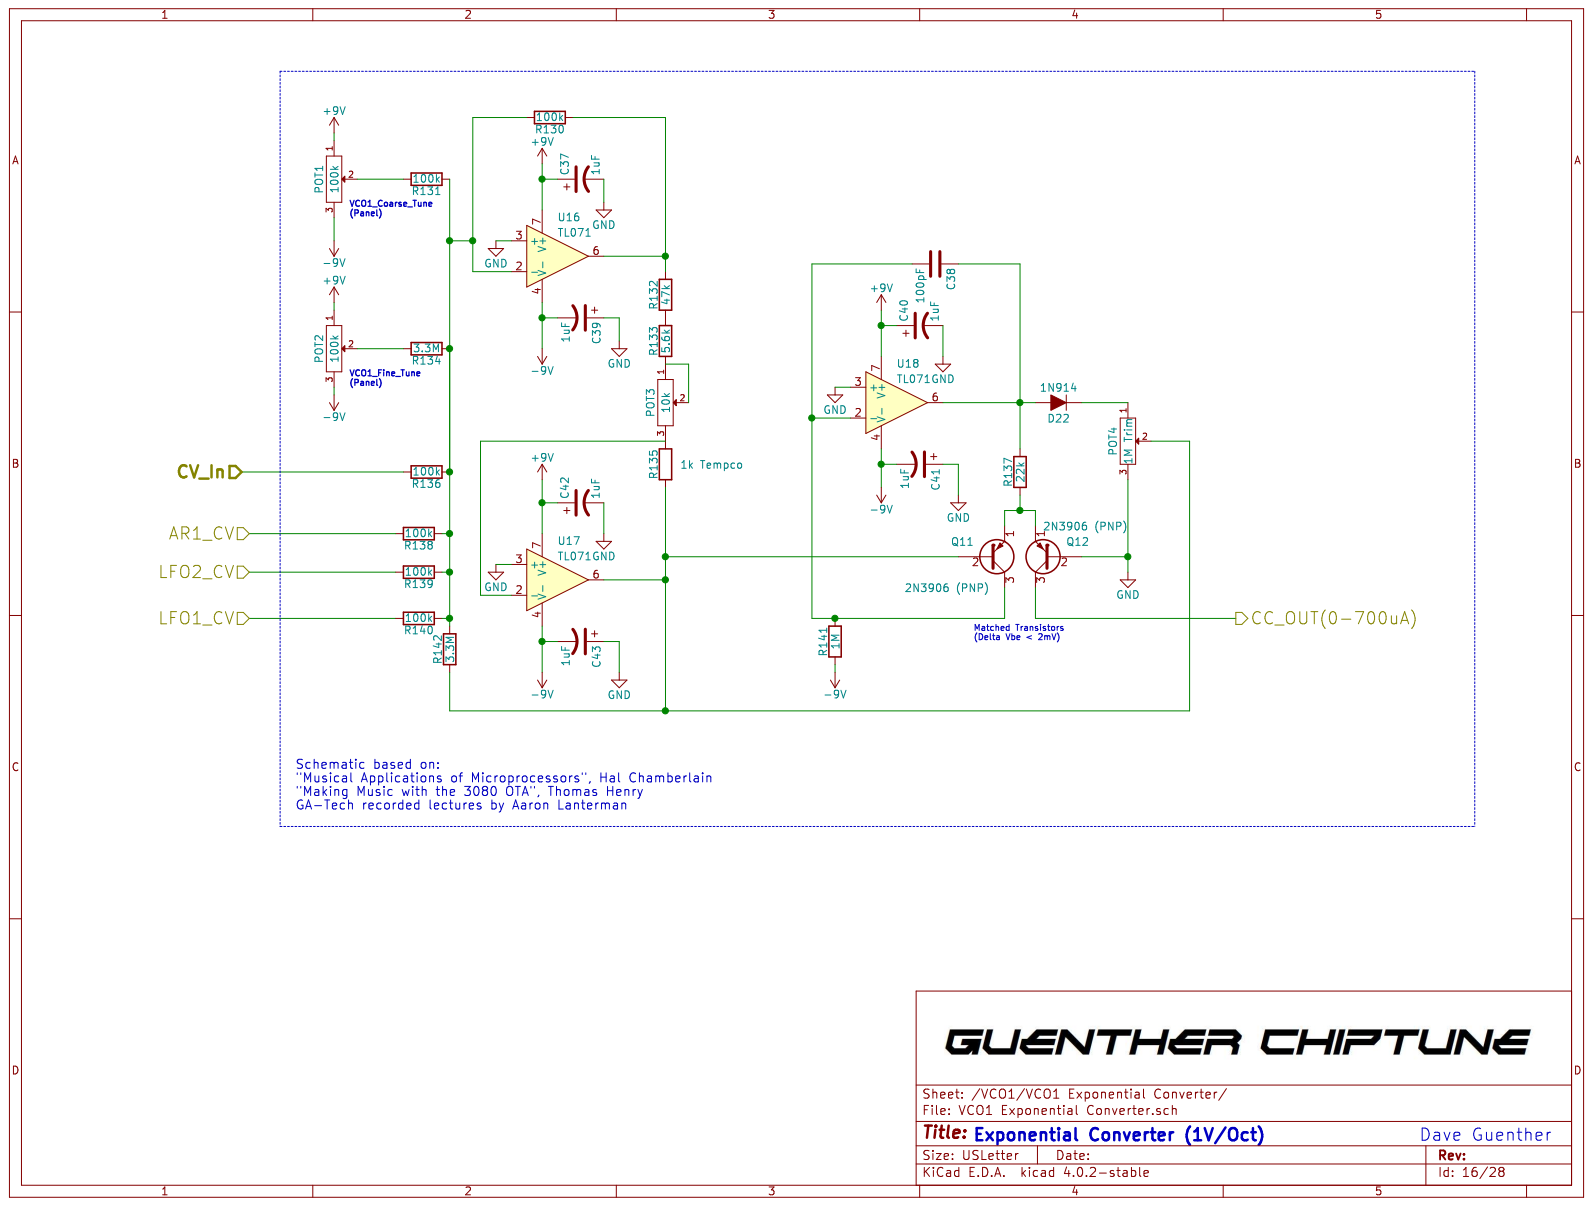
[picture p16: page 16]

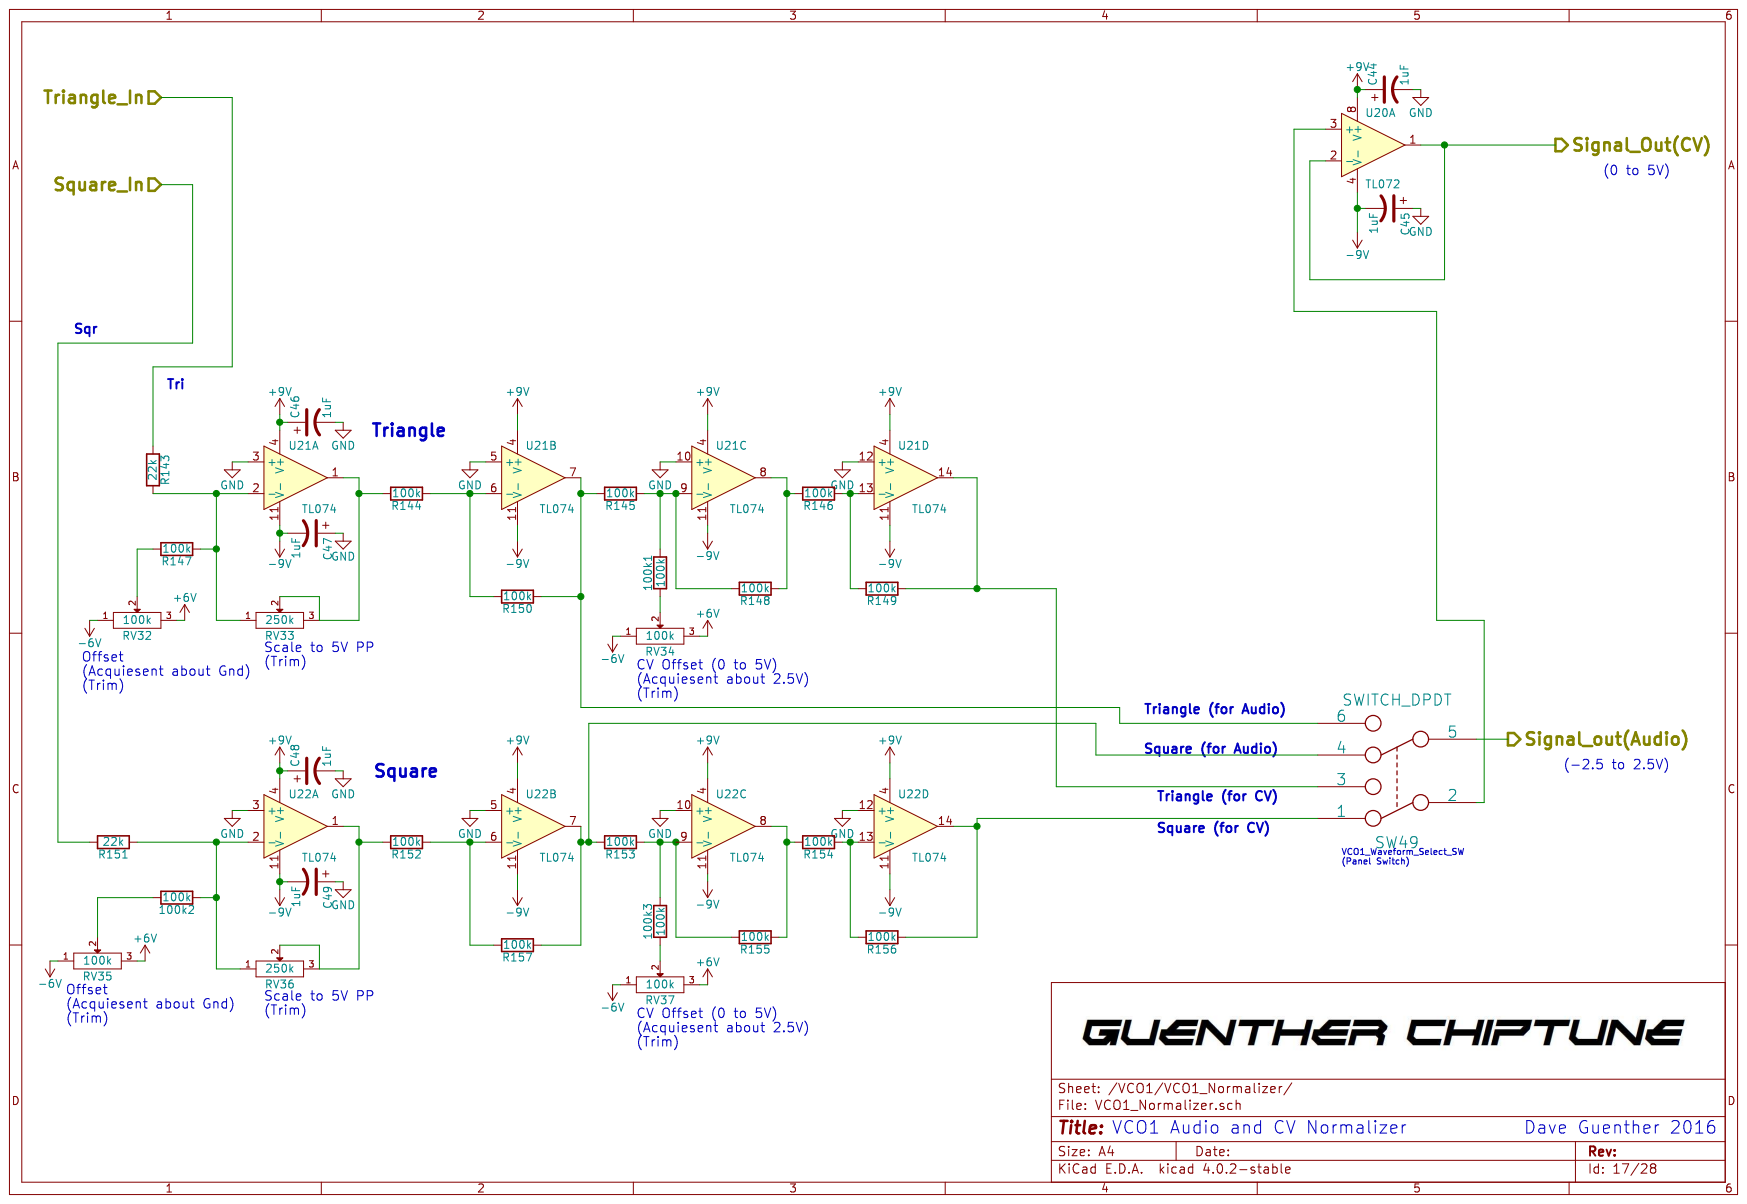
[picture p17: page 17]

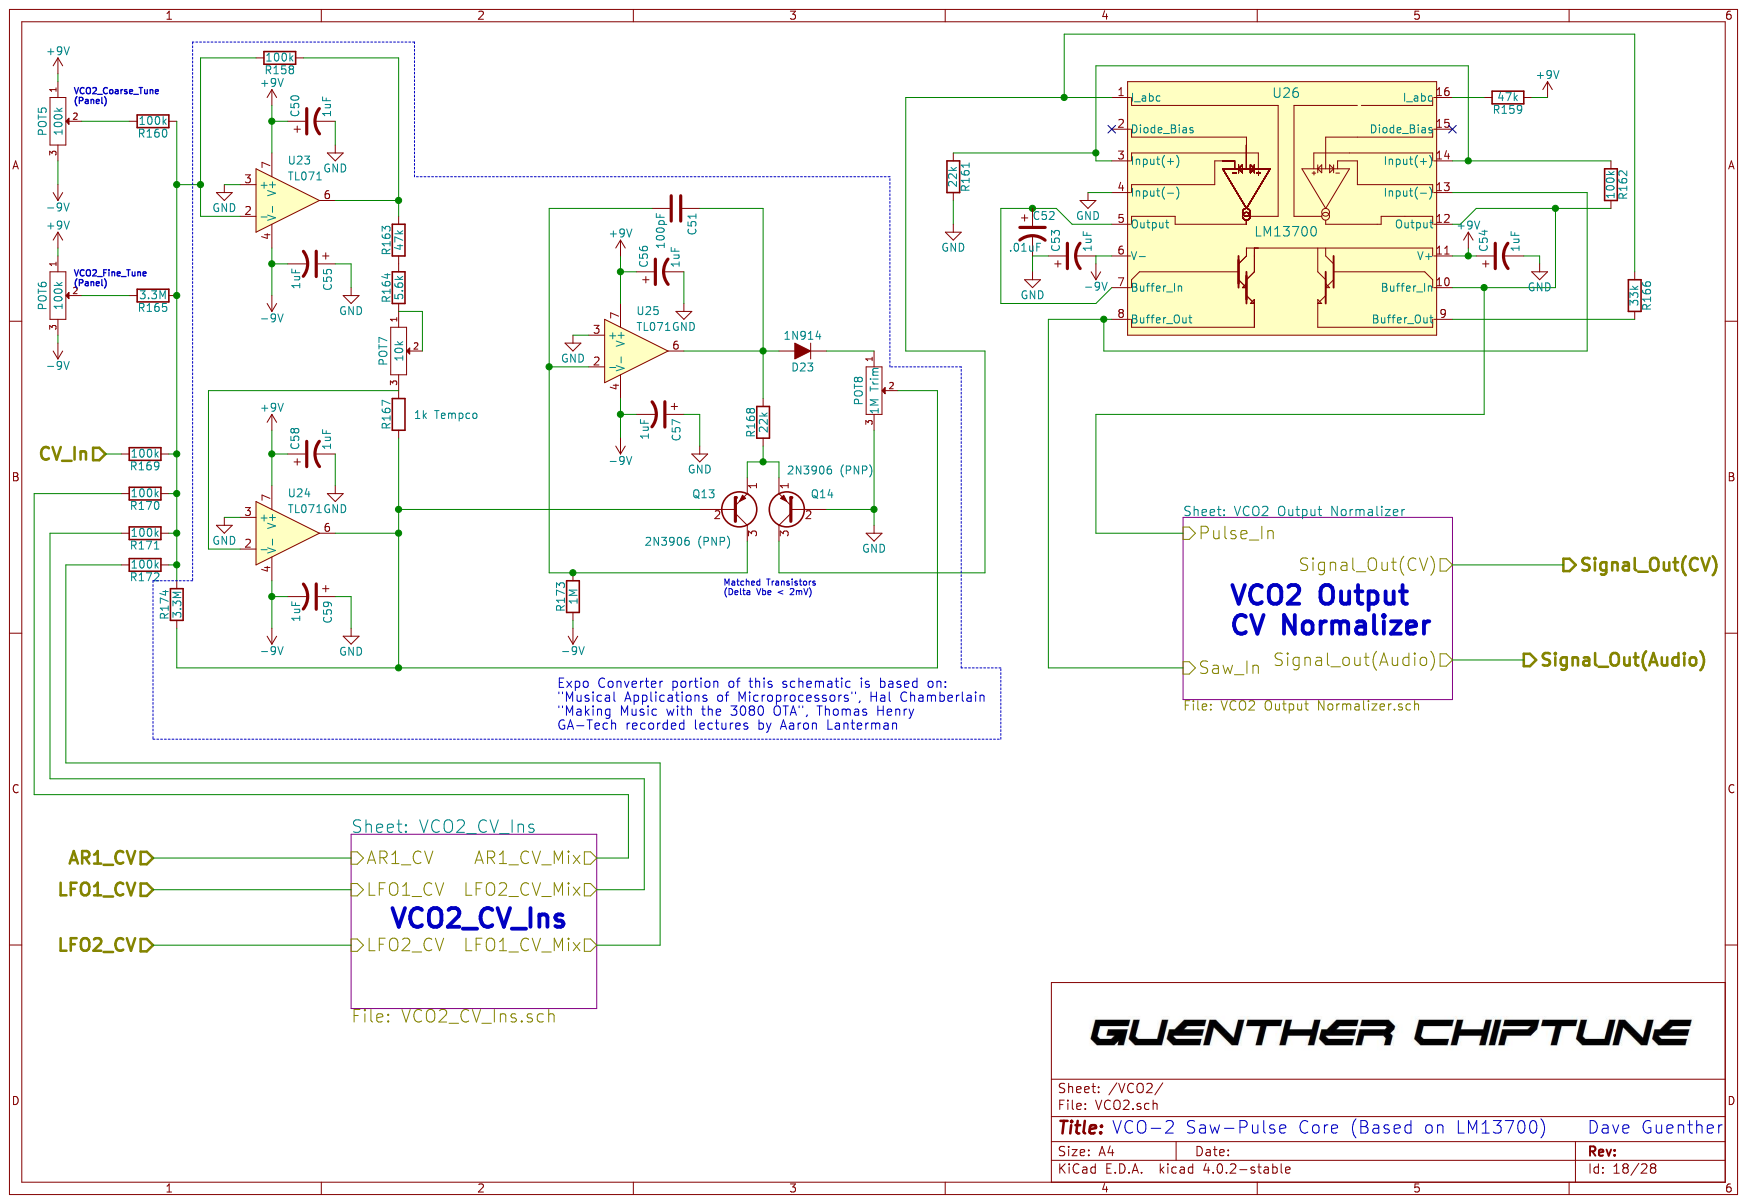
[picture p18: page 18]

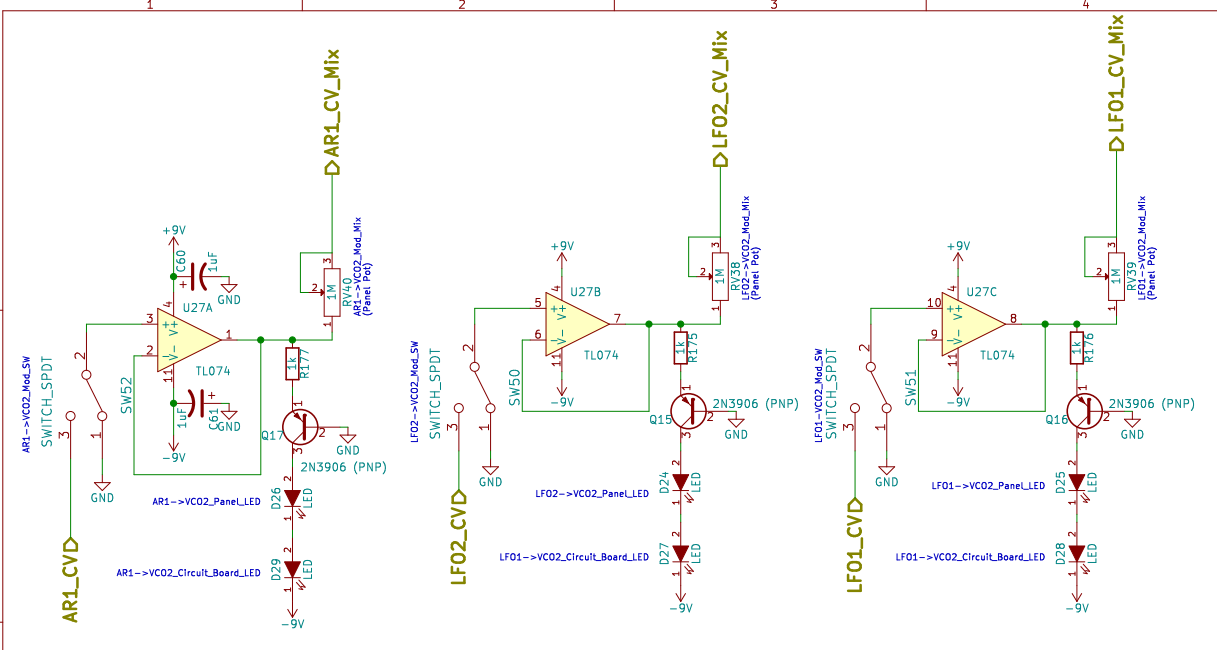
[picture p19: page 19]

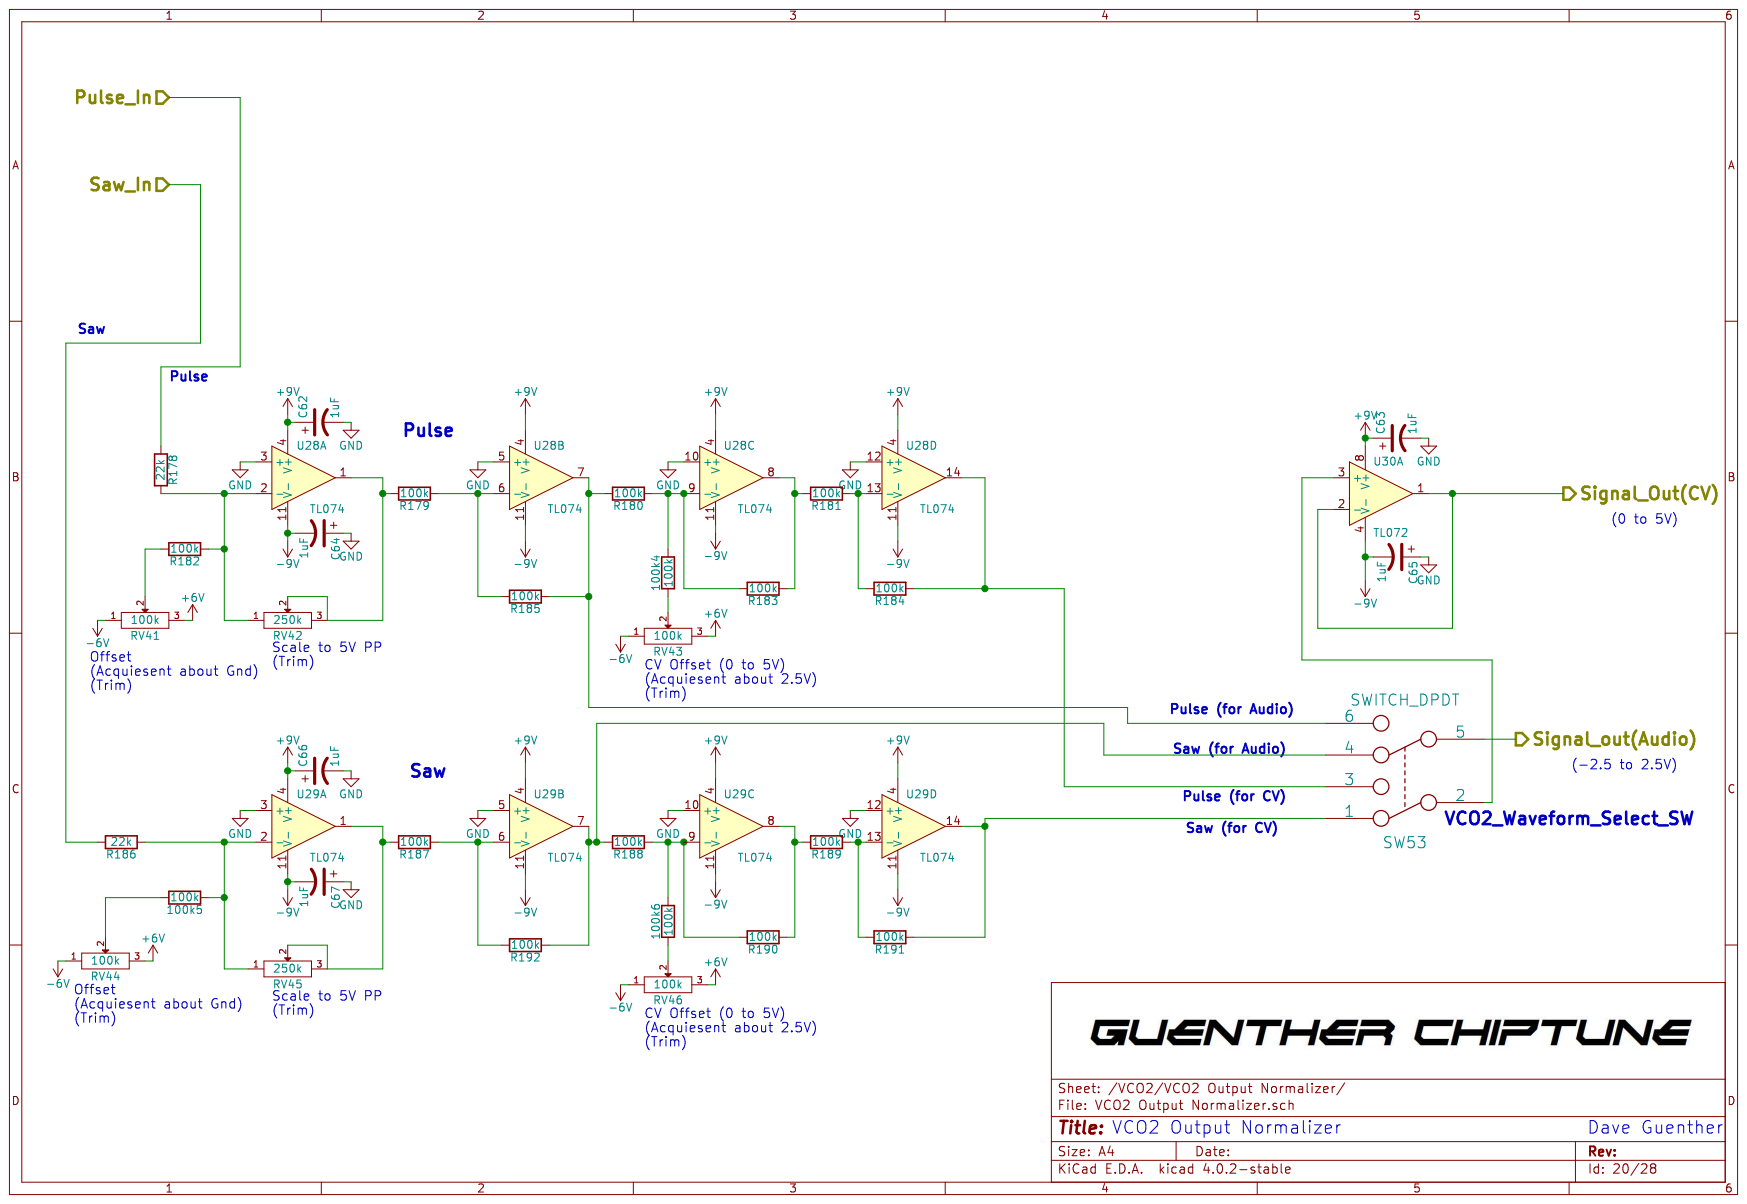
[picture p20: page 20]

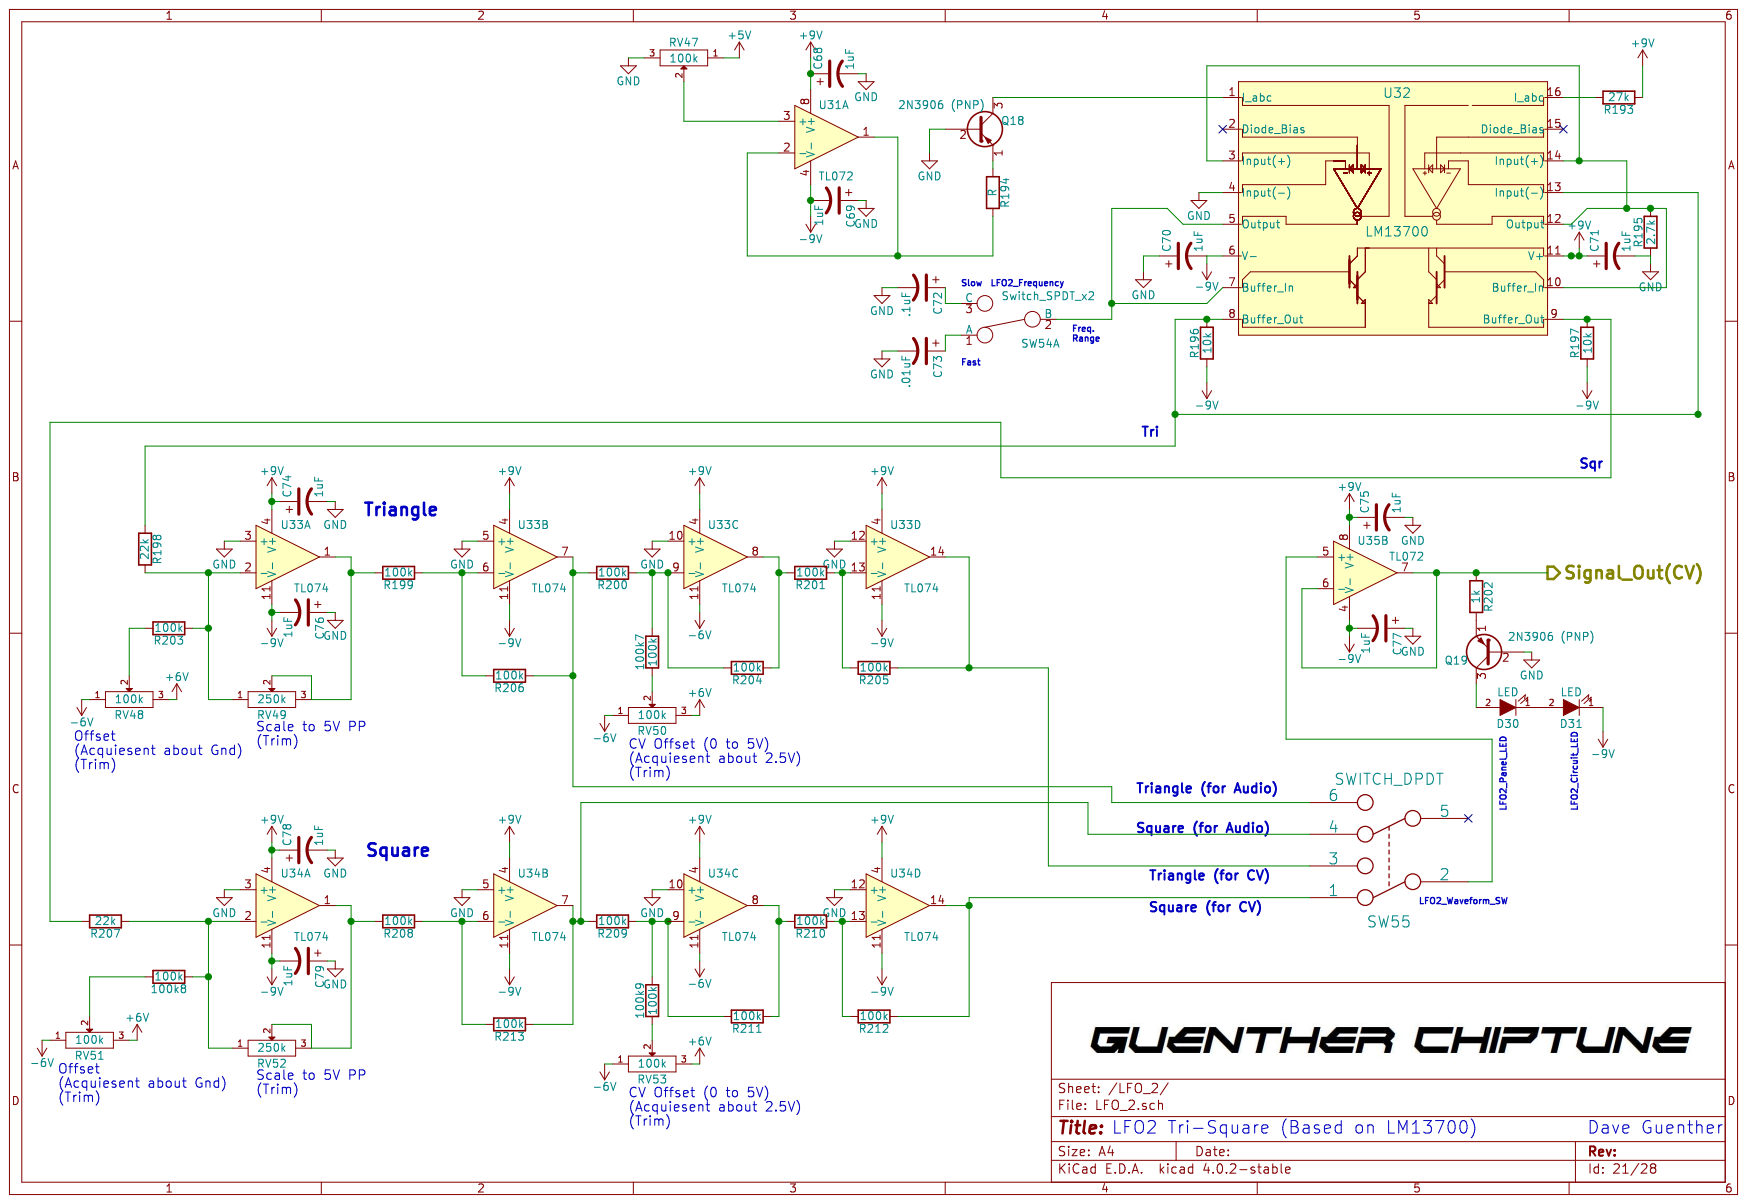
[picture p21: page 21]

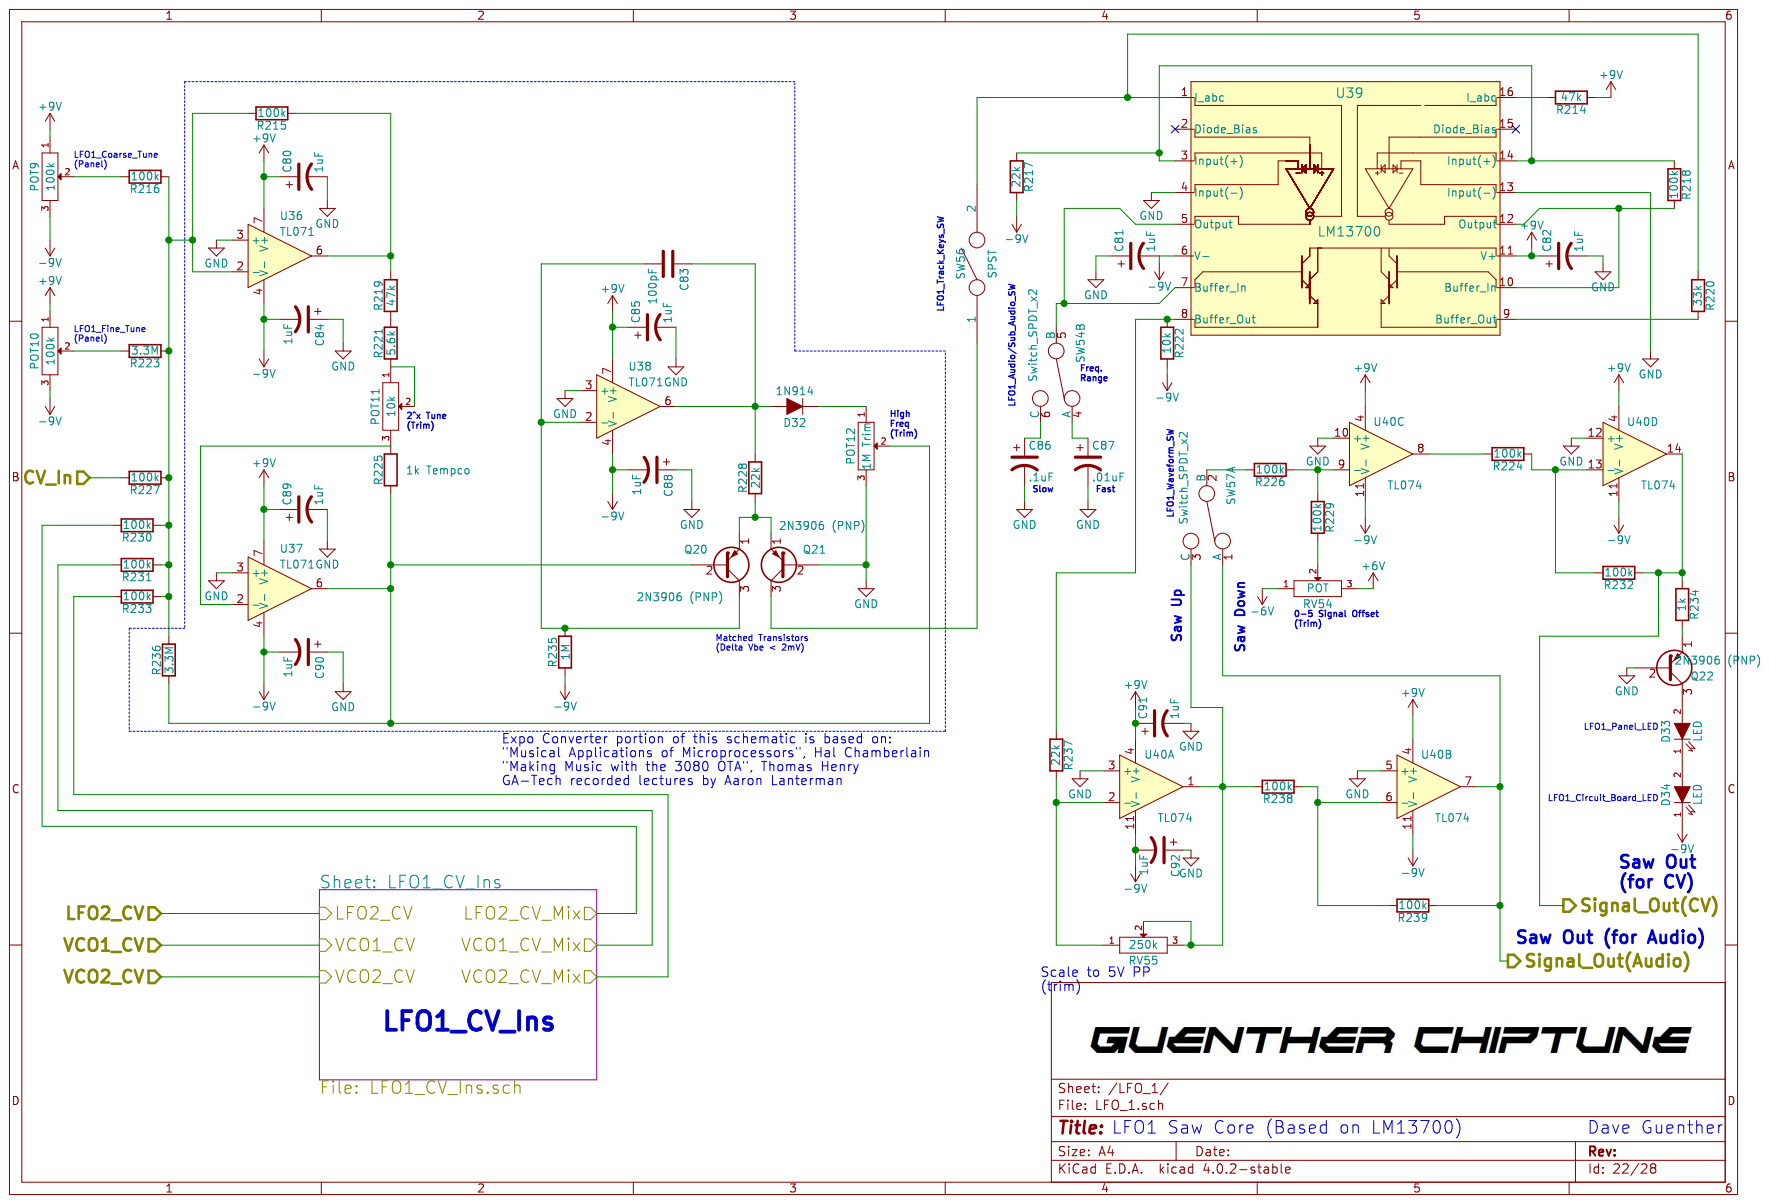
[picture p22: page 22]

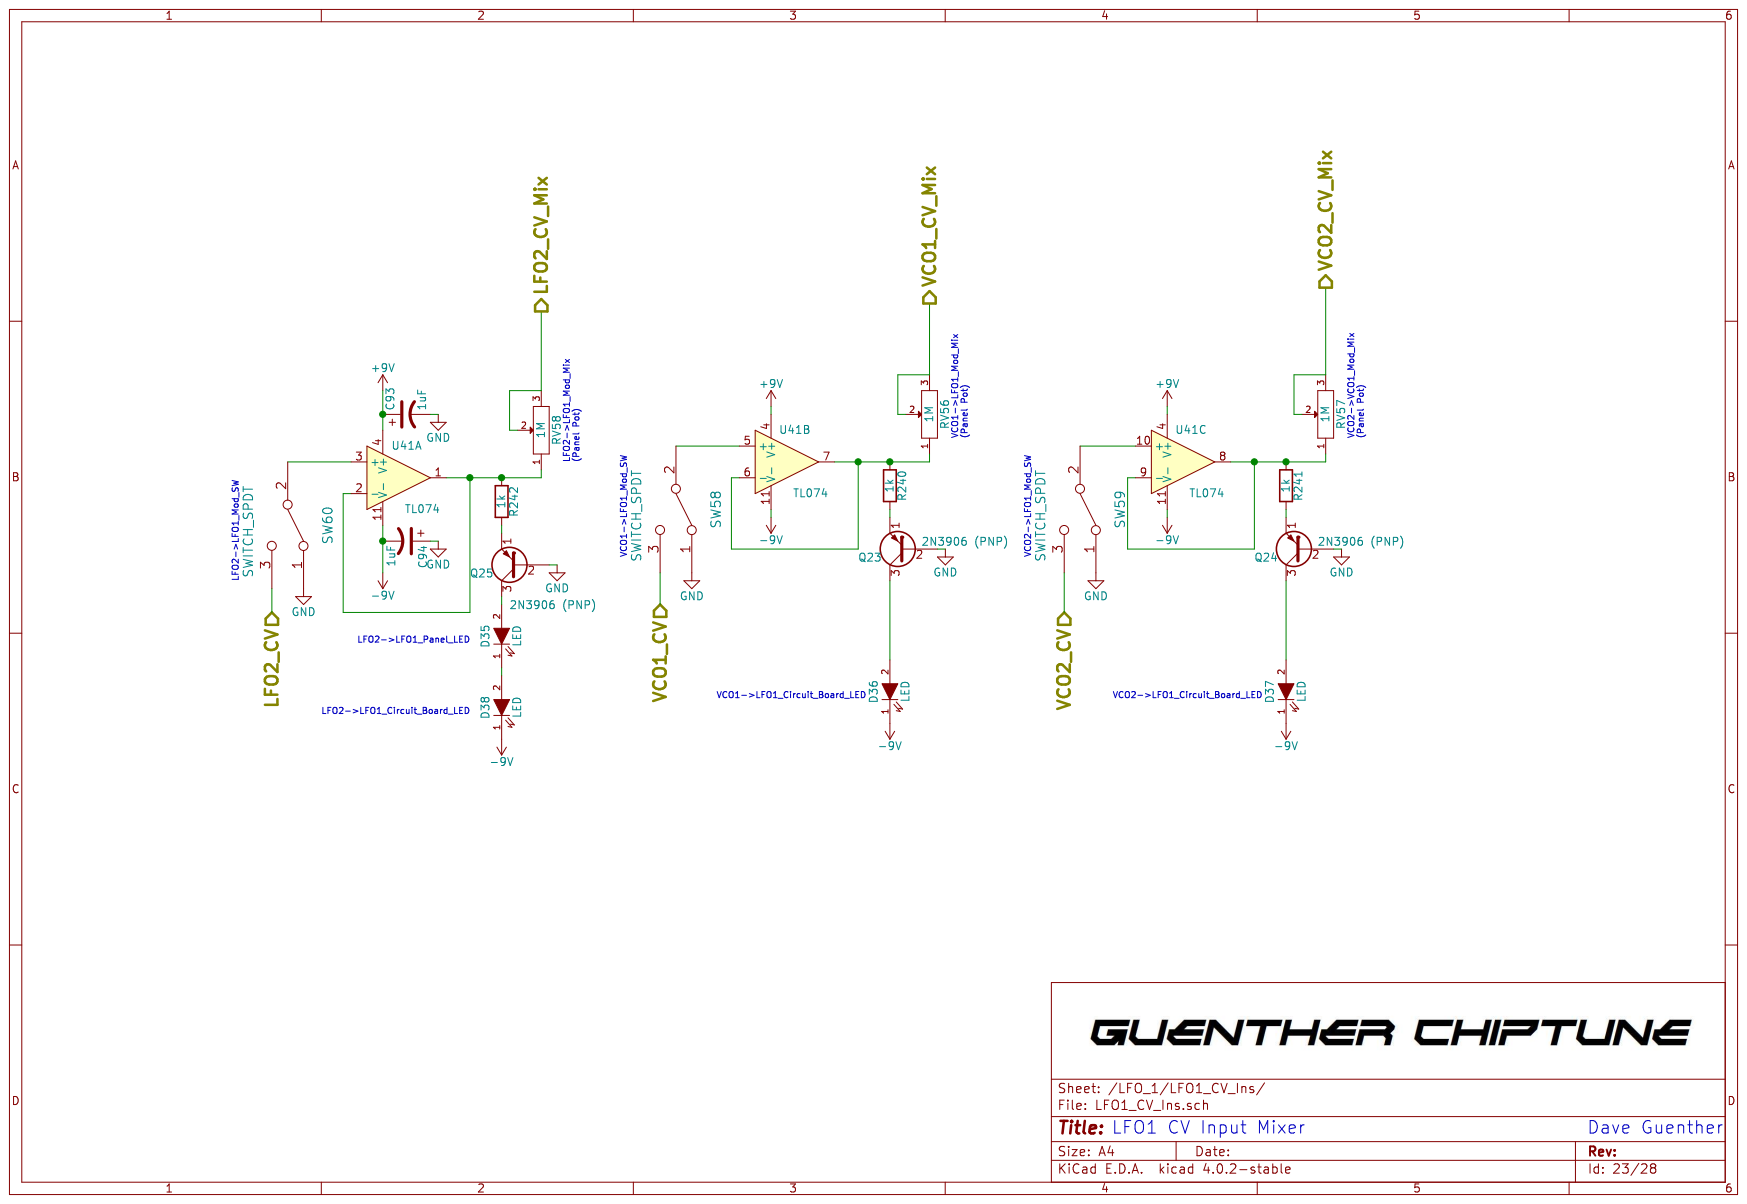
[picture p23: page 23]

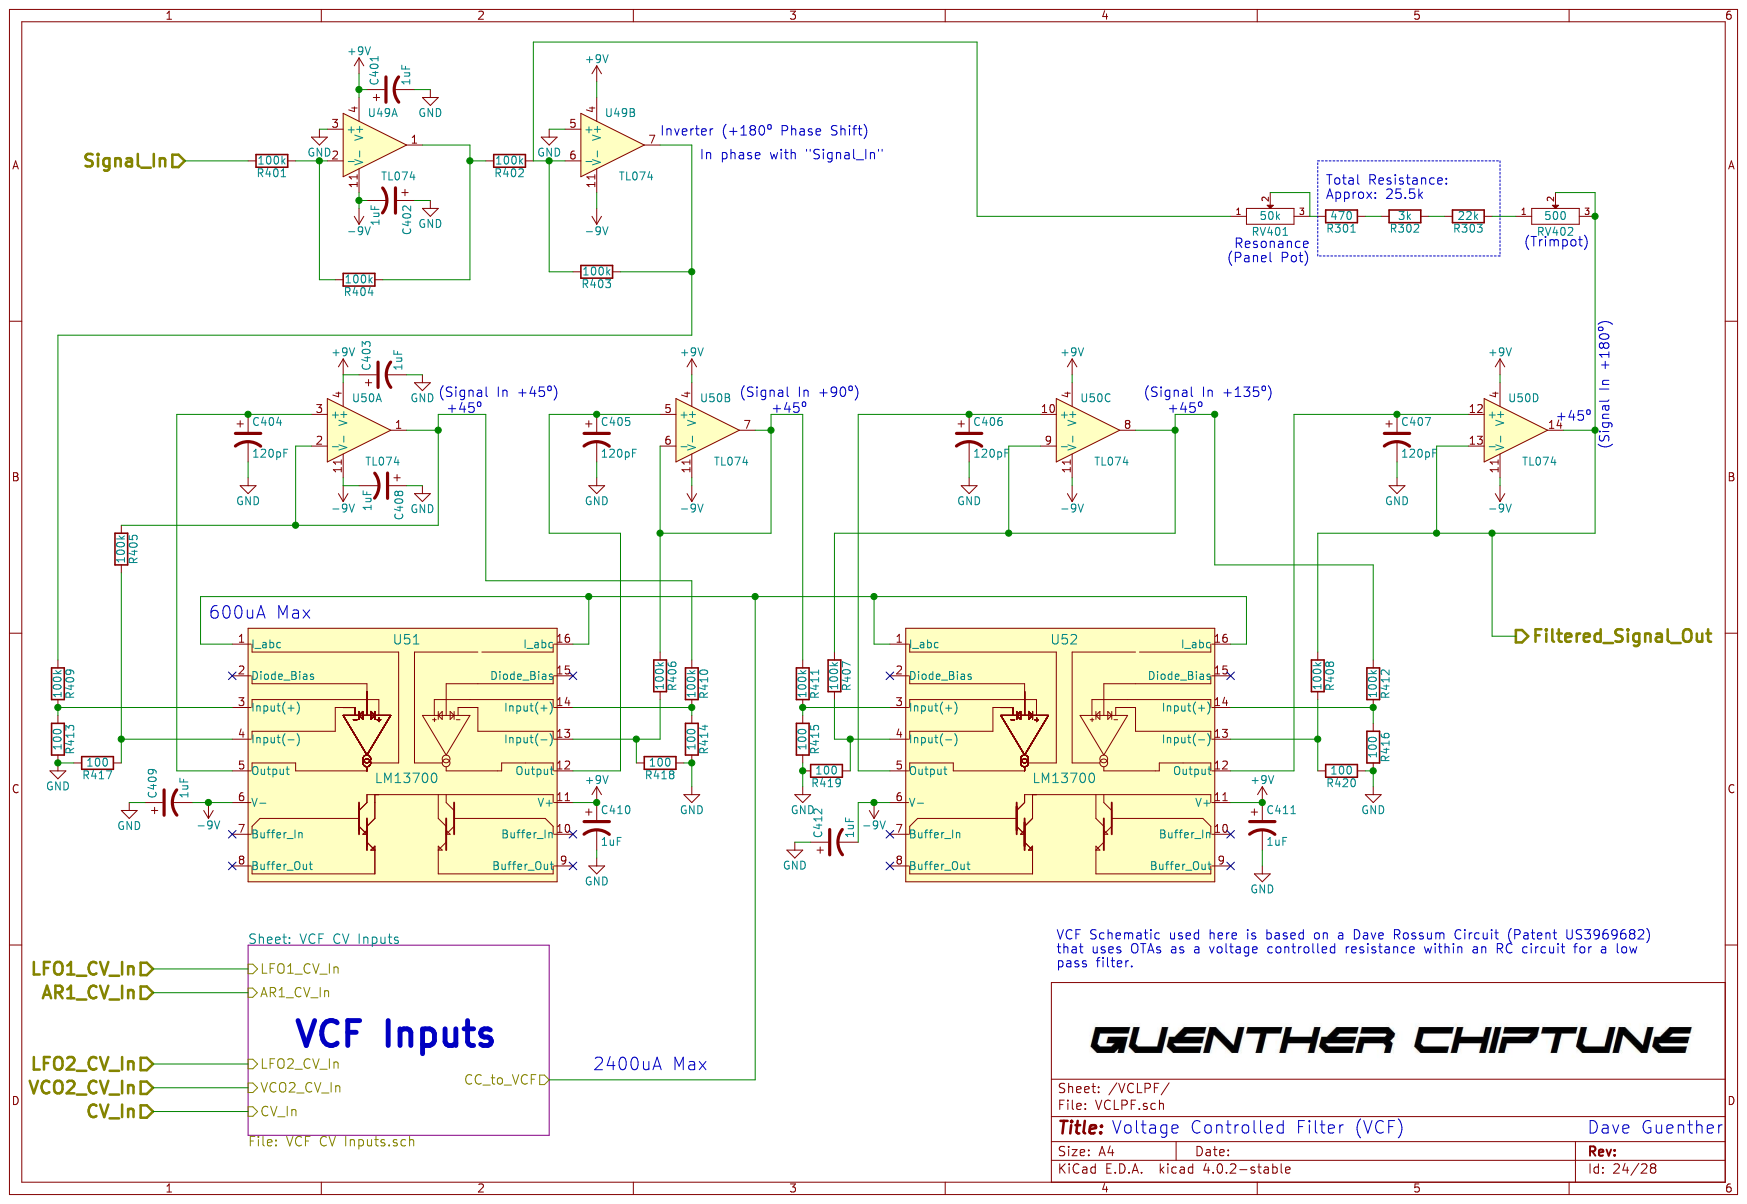
[picture p24: page 24]

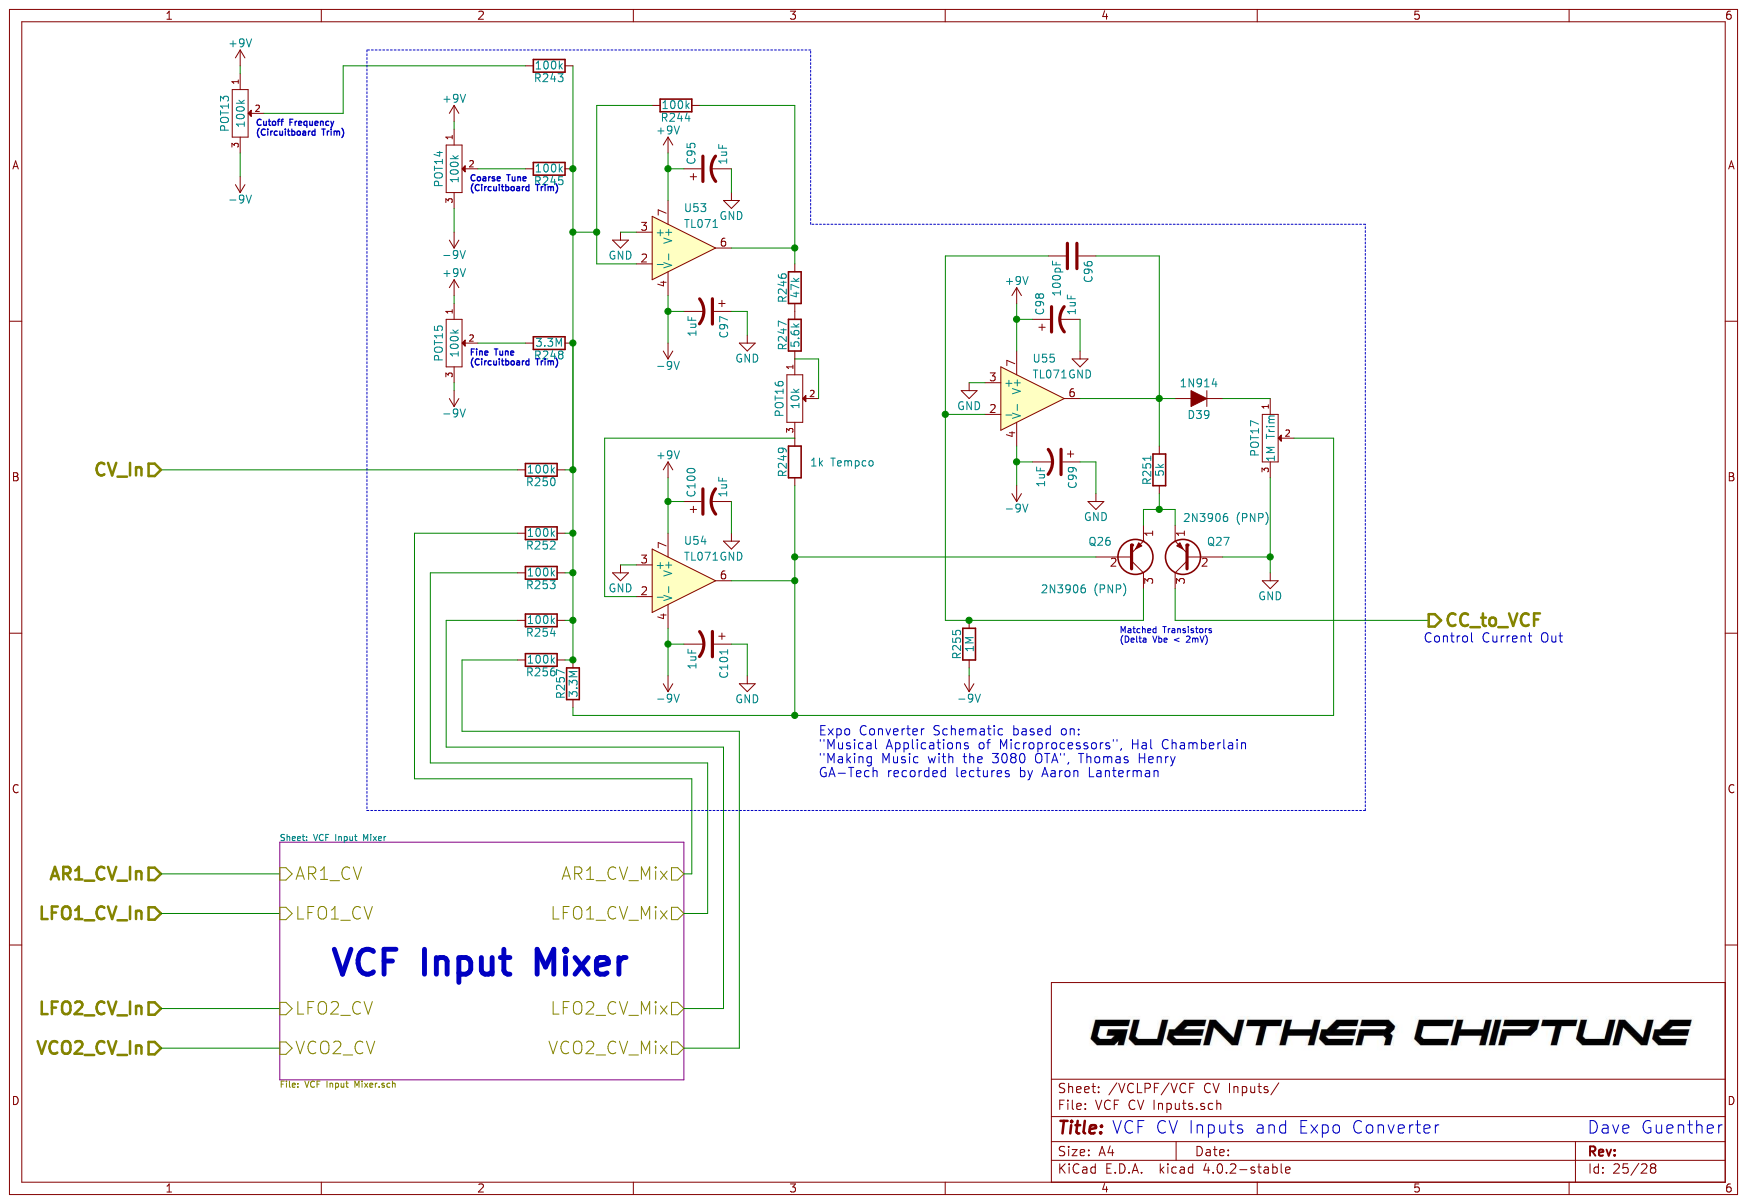
[picture p25: page 25]

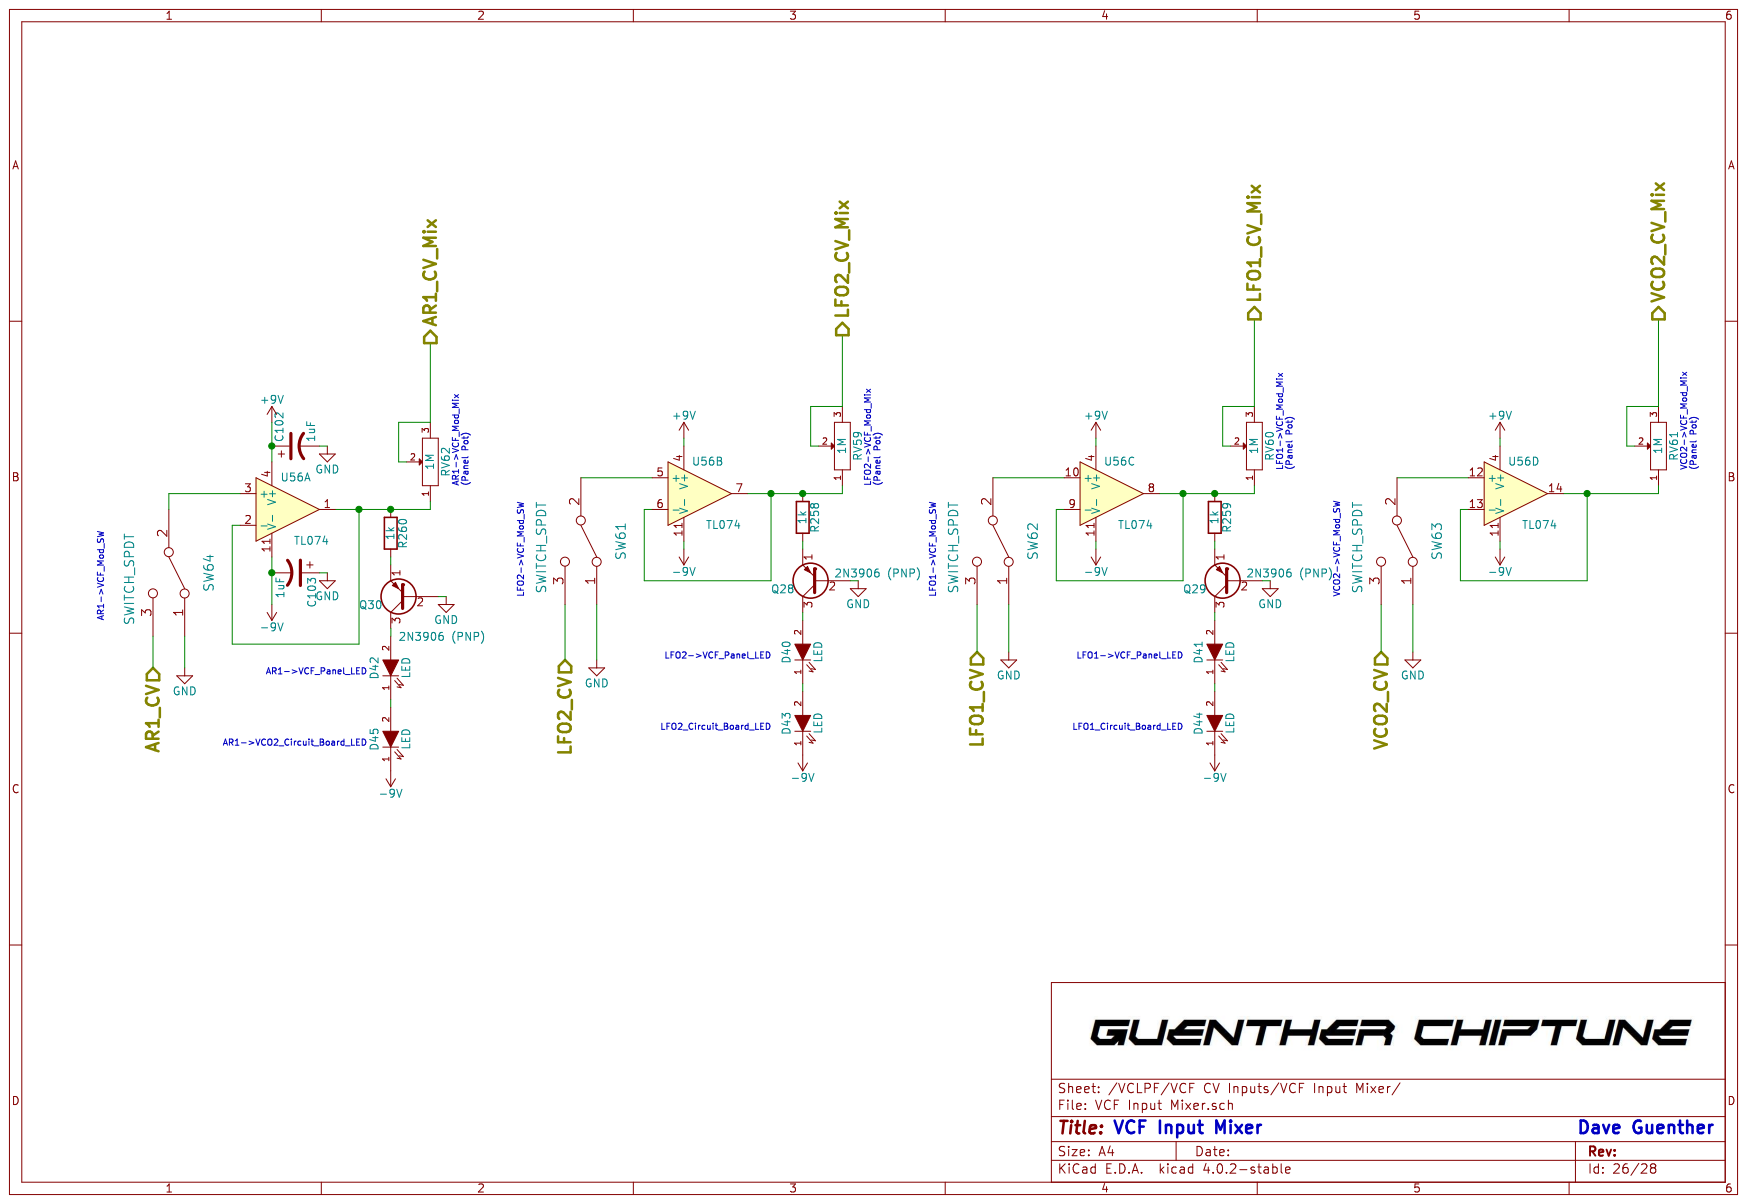
[picture p26: page 26]

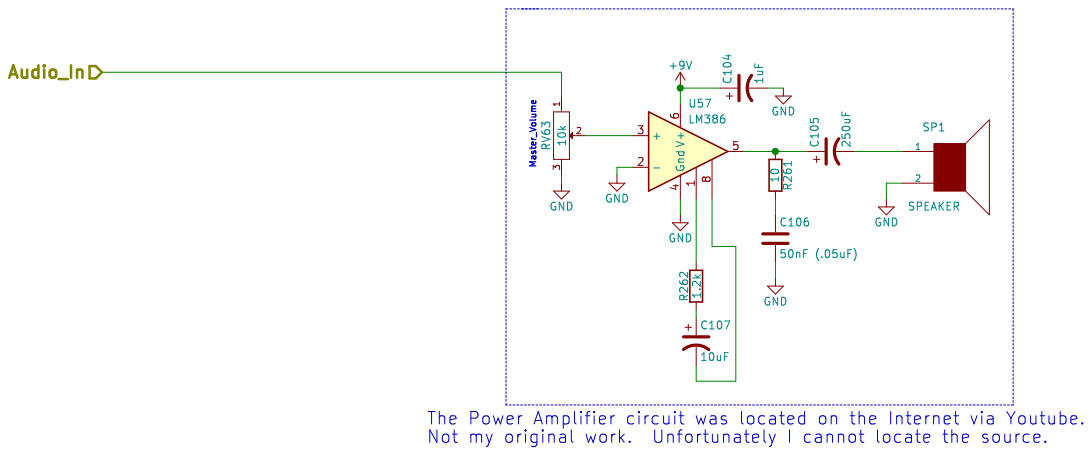
[picture p27: page 27]

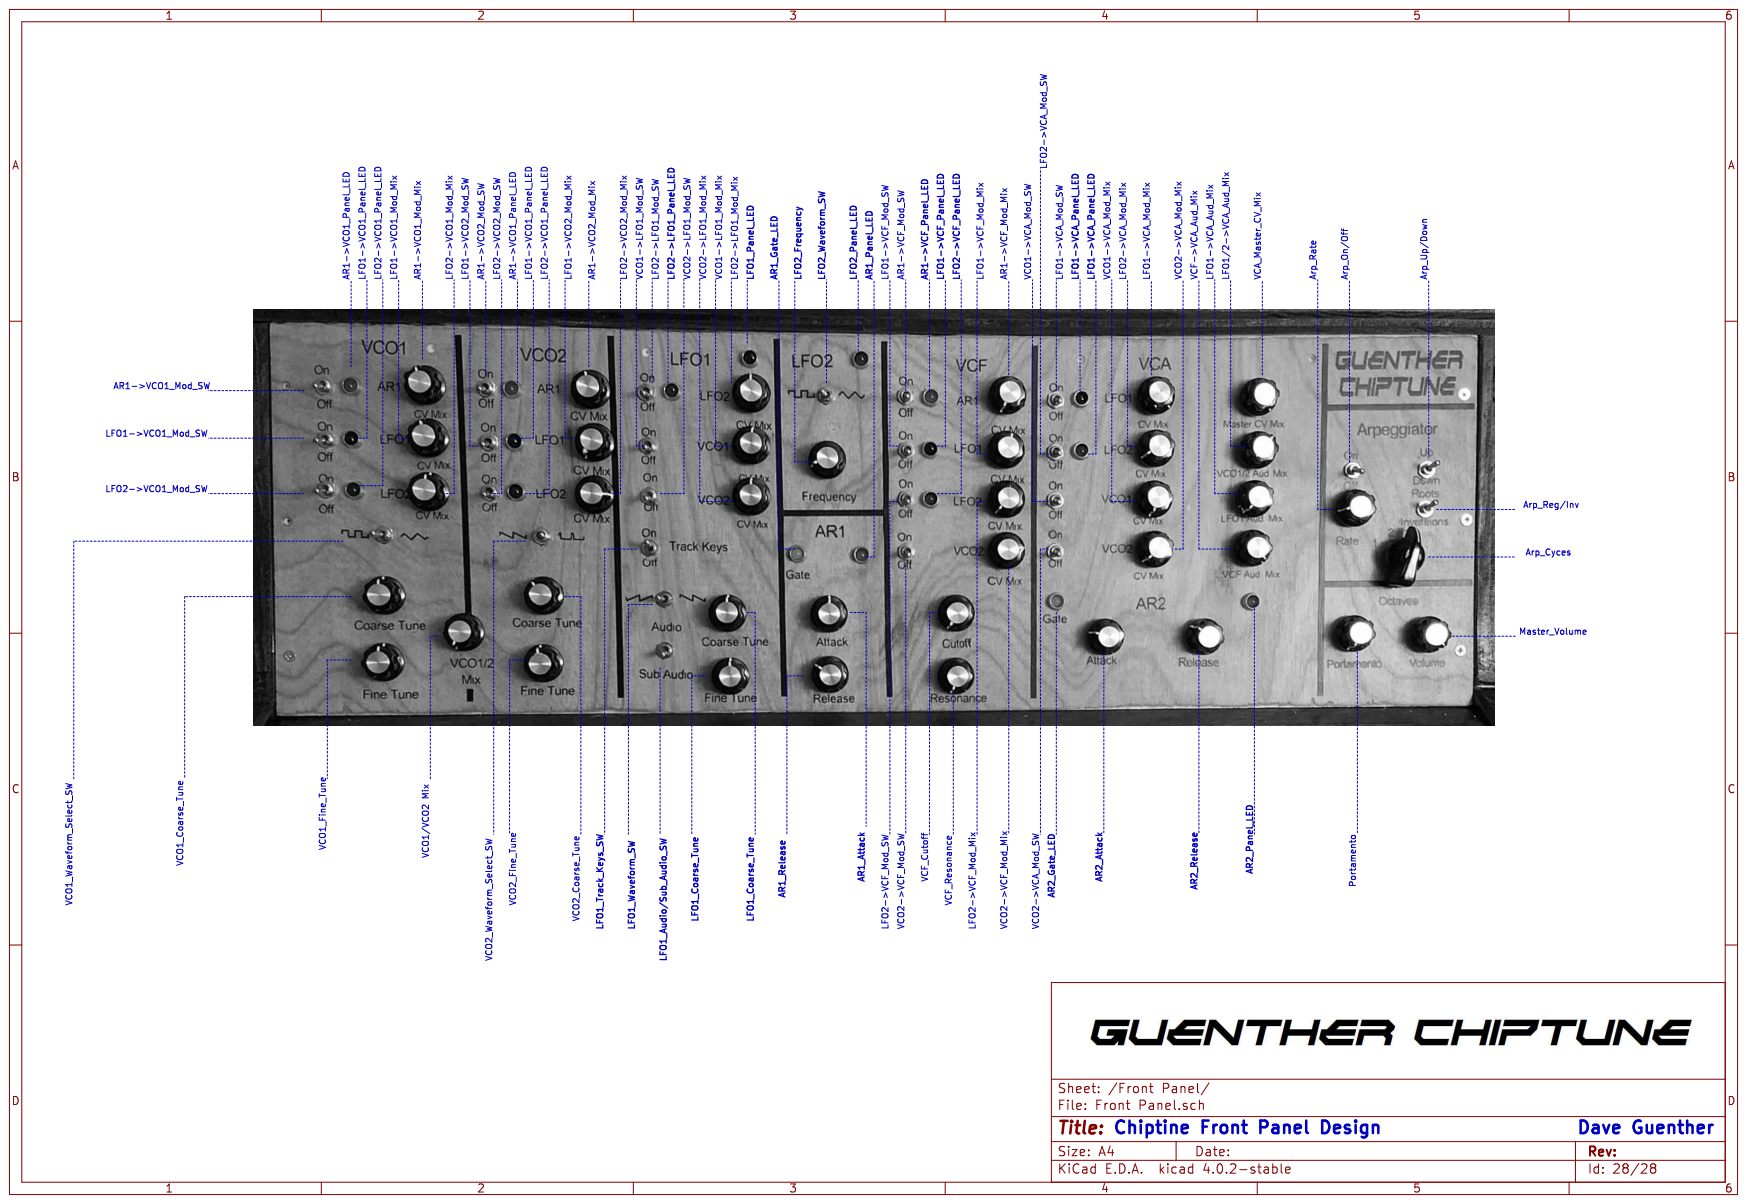
[picture p28: page 28]
