DaveGuenther/Guenther-Chiptune/Firmware ERD (Block Diagram).pdf

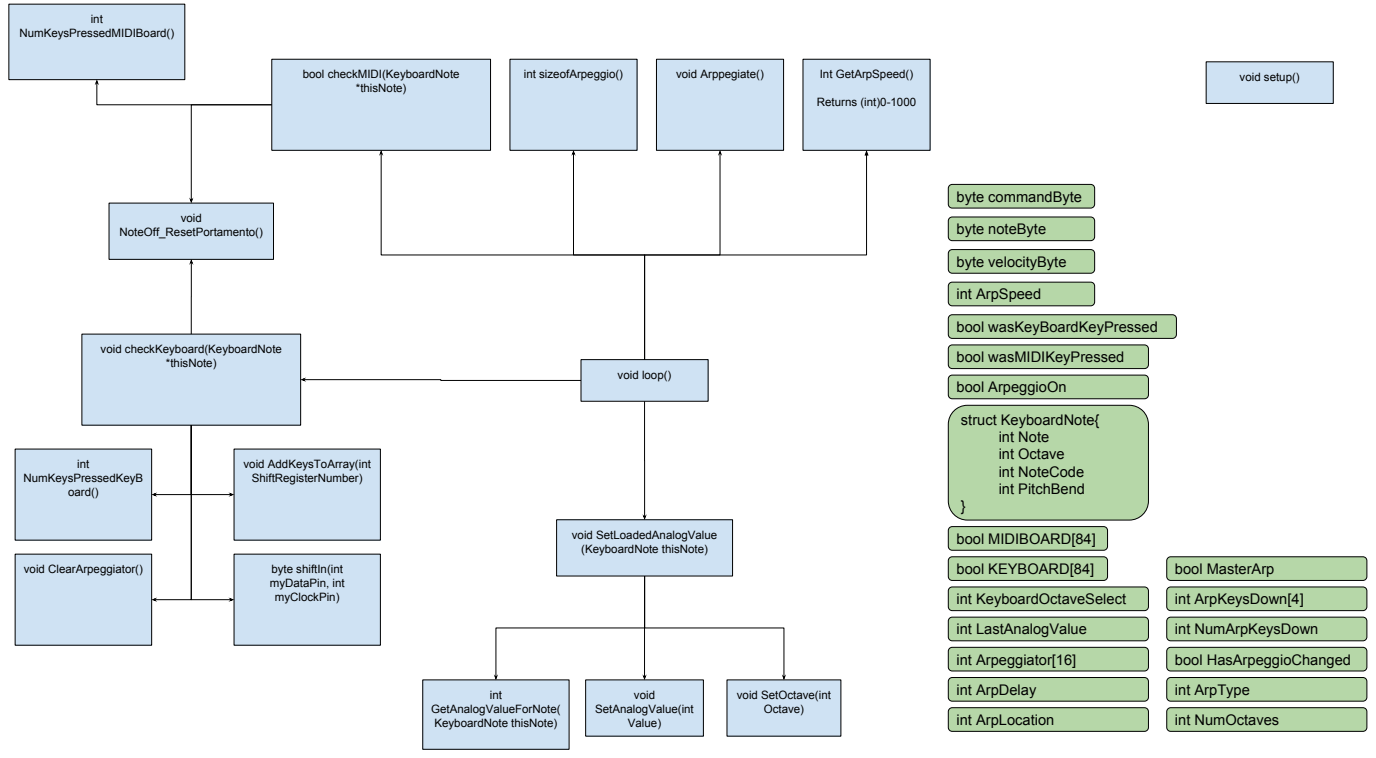
[picture p29: page 1]
Returns (int)0-1000; int NumKeysPressedMIDIBoard(); int NumKeysPressedKeyB oard(); void NoteOff_ResetPortamento(); *thisNote); void ClearArpeggiator(); int GetAnalogValueForNote( KeyboardNote thisNote); void SetAnalogValue(int Value); void SetLoadedAnalogValue (KeyboardNote thisNote); int sizeofArpeggio(); void Arppegiate(); void loop(); byte commandByte; byte noteByte; byte velocityByte; int ArpSpeed; bool wasKeyBoardKeyPressed; bool wasMIDIKeyPressed; bool ArpeggioOn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

bool checkMIDI(KeyboardNote

void setup() Int GetArpSpeed()

void checkKeyboard(KeyboardNote

void AddKeysToArray(int
ShiftRegisterNumber)

byte shiftIn(int
myDataPin, int
myClockPin)

void SetOctave(int
Octave)
