DaveGuenther/Guenther-Chiptune/Firmware ERD (Chord Diagram).pdf

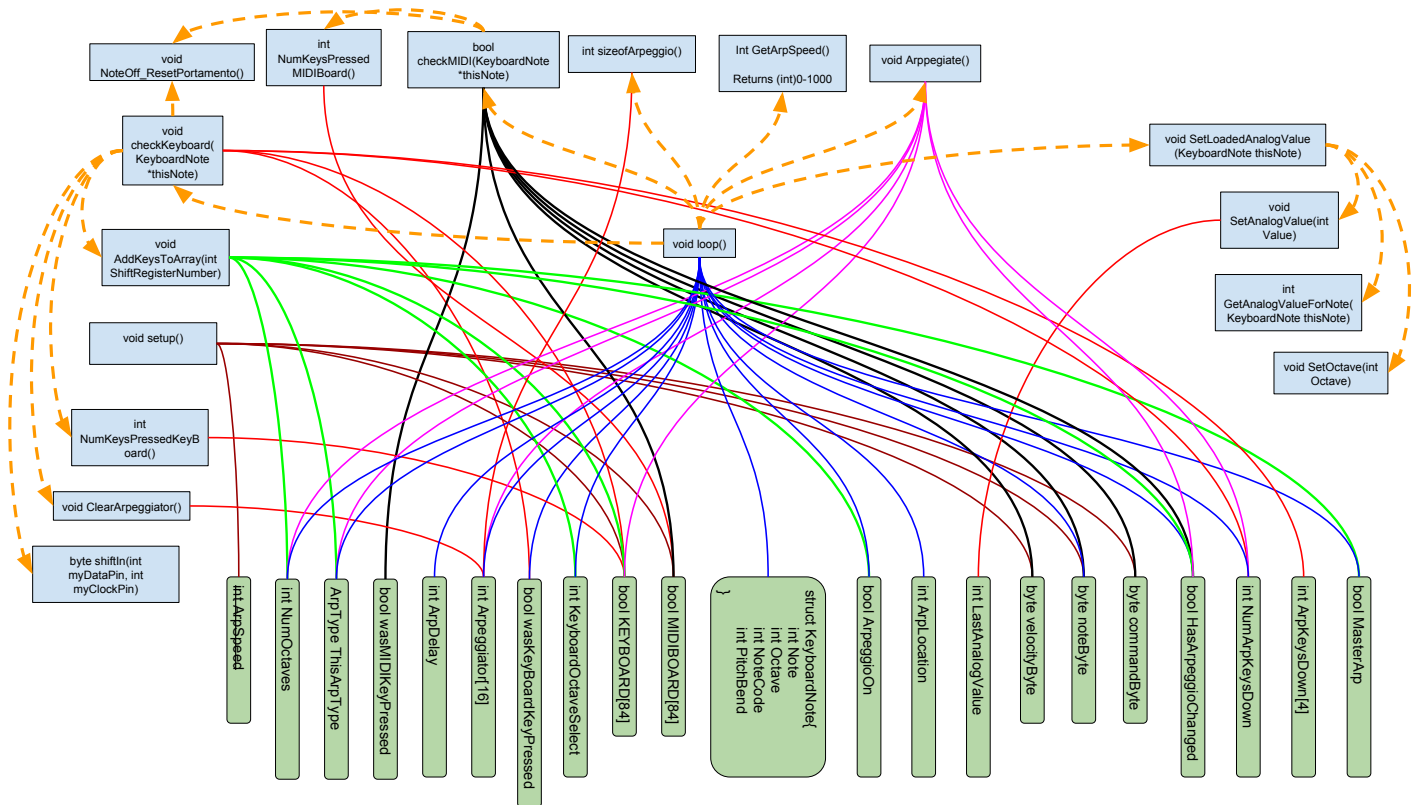
[picture p30: page 1]
void setup(); Int GetArpSpeed(); Returns (int)0-1000; int NumKeysPressed MIDIBoard(); int NumKeysPressedKeyB oard(); void NoteOff_ResetPortamento(); bool checkMIDI(KeyboardNote *thisNote); void checkKeyboard( KeyboardNote *thisNote); void ClearArpeggiator(); void AddKeysToArray(int ShiftRegisterNumber); int GetAnalogValueForNote( KeyboardNote thisNote); void SetAnalogValue(int Value); void SetLoadedAnalogValue (KeyboardNote thisNote); void Arppegiate(); int sizeofArpeggio(); void loop()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

void SetOctave(int
Octave)

byte shiftIn(int
myDataPin, int
myClockPin)
